Simmz64/EmbeddedProject/Images/powersupply.jpg

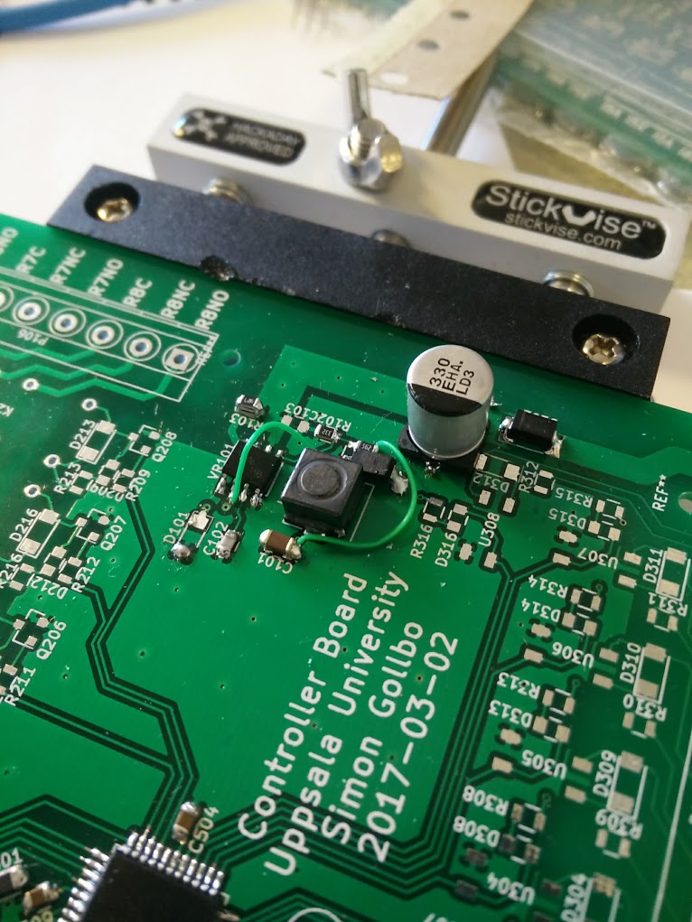
Images/powersupply.jpg
