Simmz64/EmbeddedProject/Images/Prototype.jpg

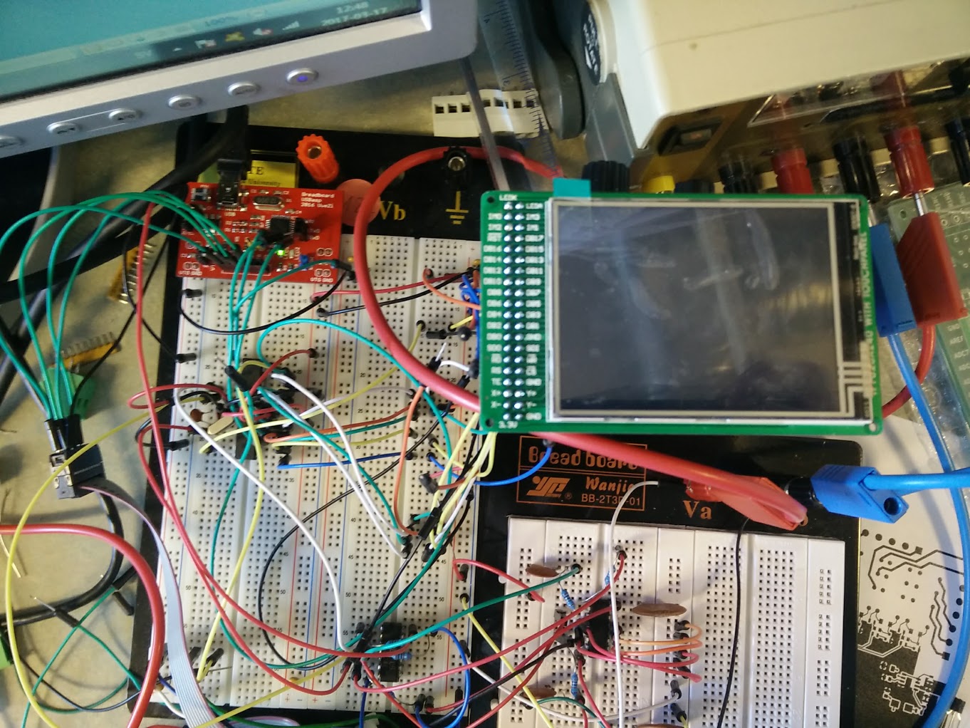
Images/Prototype.jpg
