Simmz64/EmbeddedProject/README.md

# EmbeddedProject
Project course in embedded systems
