Simmz64/EmbeddedProject/Cut from report.txt

1.1.	PID-controller
A Proportional Integrating Differentiating-controller, or PID-controller, is a feedback controller which takes as input a reference level. The difference between the reference signal and the system output is called the control error. A correctly designed controller attempts to generate control signals such that the control error goes to zero. Worded differently, the controller compares the reference level to the current output level of the system and generates a control signal, which is sent to the system with the aim to control the system to the reference level.
As the name suggests, a PID-controller consists of three parts, a proportional feedback, an integrating feedback and a differentiating feedback. These three parts each have a feedback gain assigned to them, essentially controlling how much each of the three parts affects the control signal. The process of determining sufficiently good values for the feedback gains is called tuning.
The proportional feedback is, as the name suggests, proportional to the control error. The proportional feedback gain is simply a constant with which the control error is multiplied. It is very direct in its acting, essentially constantly telling the system to move in the direction of the reference signal.
The integrating feedback keeps track of the control error over time. When properly designed, it ensures that the system, if stable, is controlled to control error zero in the steady state. Compared to the proportional feedback, the integrating feedback is slower but is able to compensate for small errors, which the proportional feedback may not be able to, given enough time.
The differentiating feedback is related to fast changes in the control error. If the system suddenly jerks, the differentiating feedback is able to provide the control signal with an extra boost to compensate for the quick change in system output.
