Simmz64/EmbeddedProject/SimonGollbo_EmbeddedProject_Final.pptx

## Electron gun vacuum system control

Project in Embedded Systems

## Outline

- Purpose and project specifications
- Work
- Results and summary
- Demonstration

## Purpose

- Control system for vacuum system

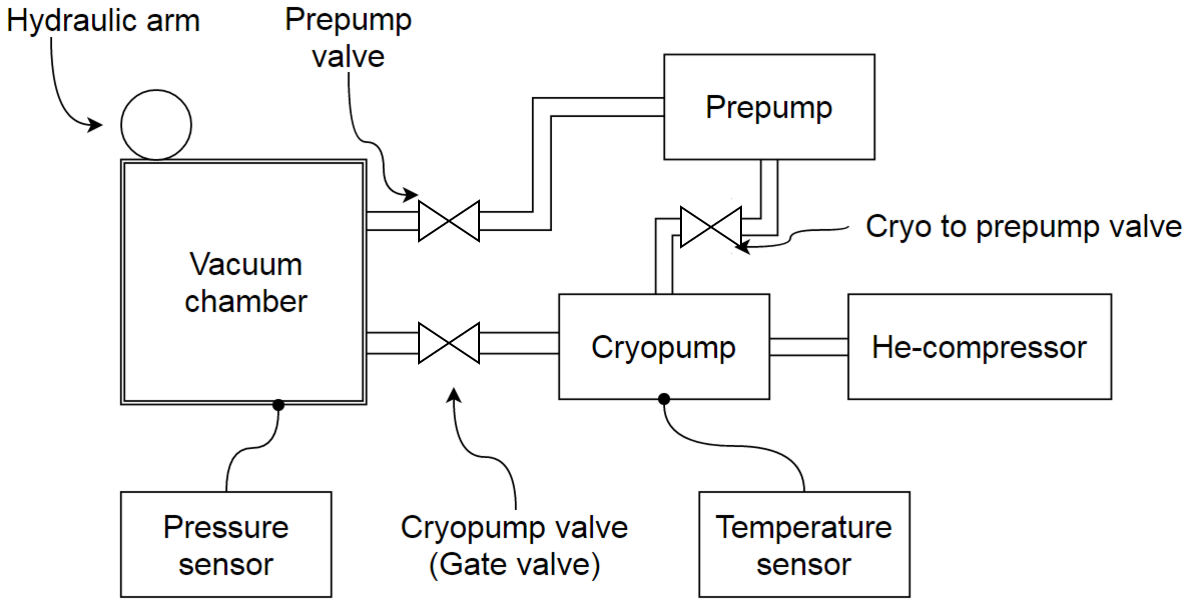
[picture p19: figure]

## Specifications

- Milestones
  - Prototype on breadboard with working touch screen and digital I/O
  - Prototype on breadboard with working universal PID-controller
  - Finished PCB with working universal PID-controller

## Development tools

- AtmelStudio 7.0
- Sublime Text
- Git
- AVRDUDESS
- KiCad

## Work

- Software
  - Microcontroller
  - Touch screen display
  - Touch screen touch interface
    - Polling
  - GUI
  - Controls
    - Binary search
  - PID-controller

## Work

- Prototype


## Work

- PCB design
  - Datasheets
  - Footprints
- KiCad

## Work

- PCB

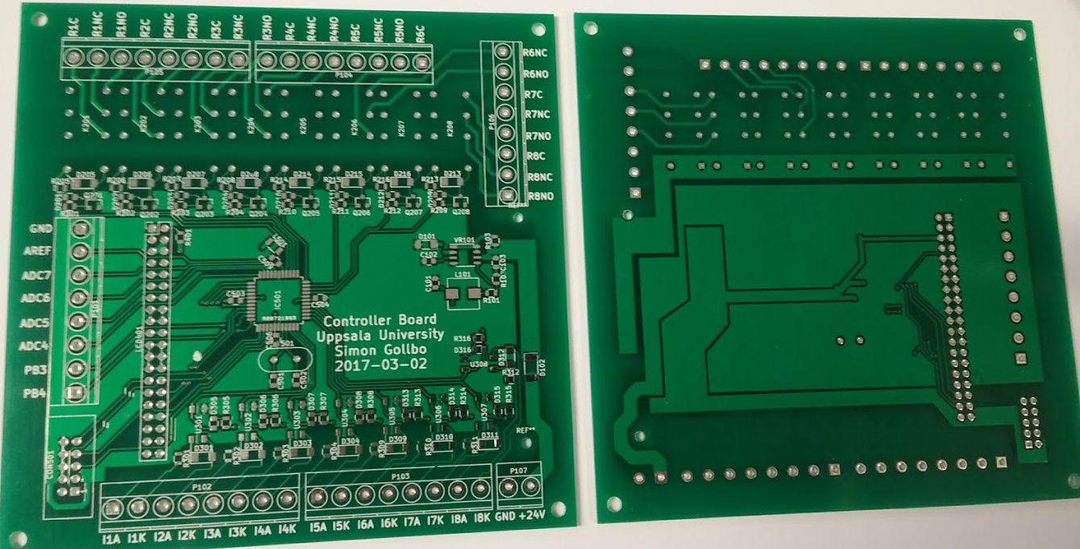
[picture p20: figure]
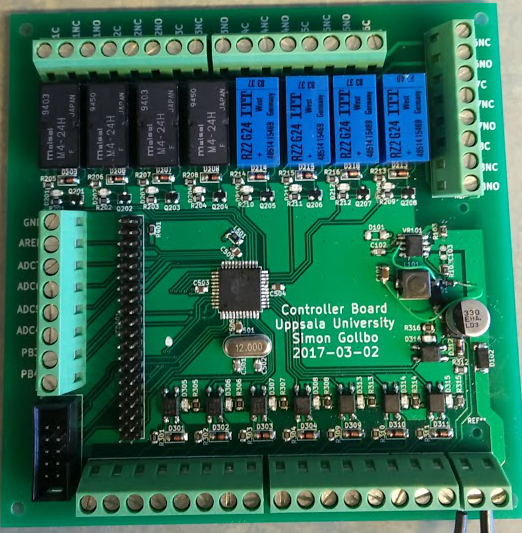
[picture p21: figure]
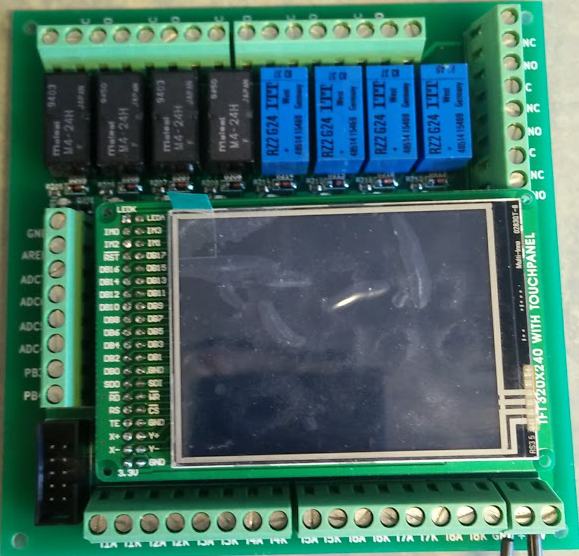
[picture p22: figure]
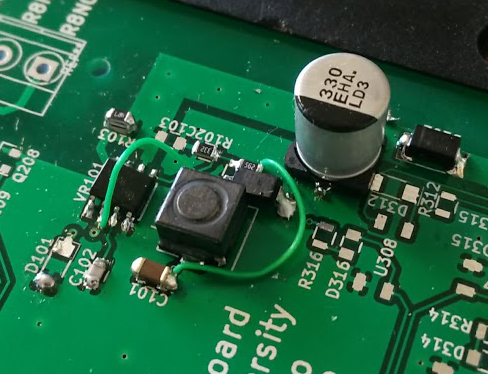
[picture p23: figure]

## Results

- Working PCB
  - GUI for vacuum system
  - GUI for PID-controller

## Summary

- Prototype and test
- PCB design
- PCB test

## Demonstration

## Slide 13
