Simmz64/EmbeddedProject/SimonGollbo_EmbeddedProject_Phase2.pptx

## Phase 2

Work done and progress made

## Outline

- Work done
- Progress made
- Next phase

## Work done

- Additional coding
  - Numerical input interface
  - Started PID-interface
  - Fixed-point decimal handling
  - ADC tested (using PWM + LP filter)

## Work done

- PCB design
  - Schematics drawn (not yet complete)
  - PCB placement started (also not yet complete)
- Relays
  - Testing of mechanical relays
  - To be used as input/output

## Progress made

- PCB progress
- Code progress
- Relays (input/output)
- Time schedule

## Next phase

- Focus on
  - Software logic (what action are allowed when)
  - Finishing PCB
  - Finishing PID
