Simmz64/EmbeddedProject/SimonGollbo_EmbeddedProject_Phase1.pptx

## Phase 1

Work done and progress made

## Outline

- Work done
- Progress made
- Next phase

## Work done

- Pre-lab access
  - Git repository
  - Seeking information
    - Screen
    - Code examples
  - Clean room

## Work done

- Post-lab access
  - Getting the screen to work
    - Communication protocol
    - Decoding datasheet
  - Getting the touch interface to work
    - Measurement method
  - Starting GUI design
    - Detail
    - Drawing speed
  - Specifications for PCB

## Progress made

- Screen
  - Works
  - Library
- Touch interface
  - Measurements
  - Library
- PCB
- Time schedule

## Next phase

- Focus on
  - PCB design
  - Software logic
  - Microcontroller to industrial electronics
  - PID regulator
  - Some minor GUI work
