Simmz64/EmbeddedProject/Images/PCB1.jpg

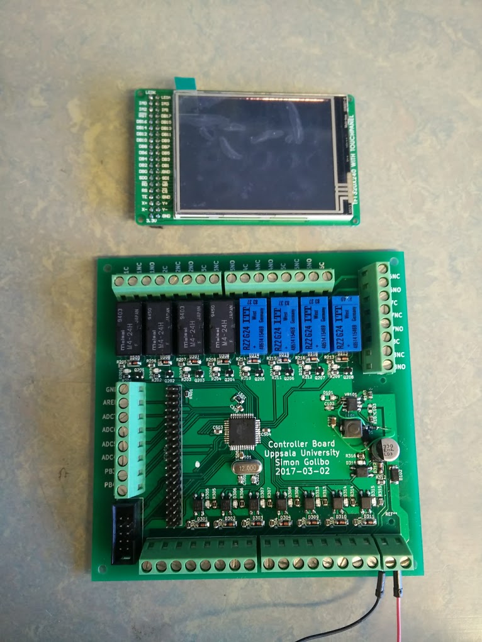
Images/PCB1.jpg
