Simmz64/EmbeddedProject/Images/PCB_clean.jpg

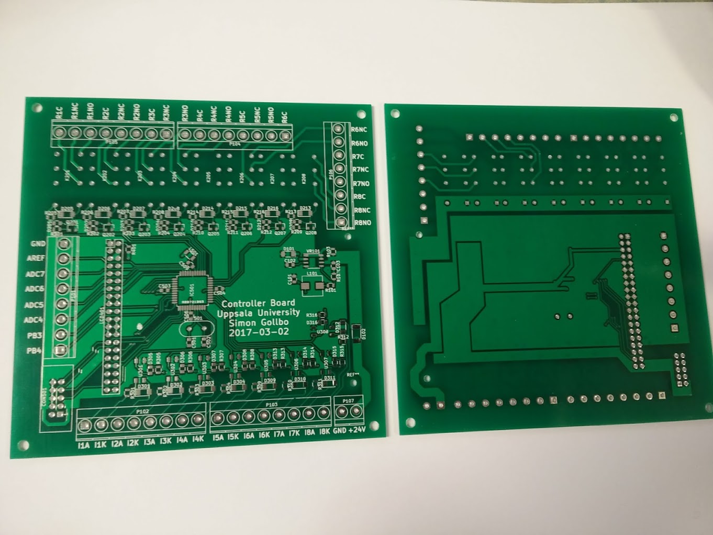
Images/PCB_clean.jpg
