Simmz64/EmbeddedProject/Images/PCB_complete.jpg

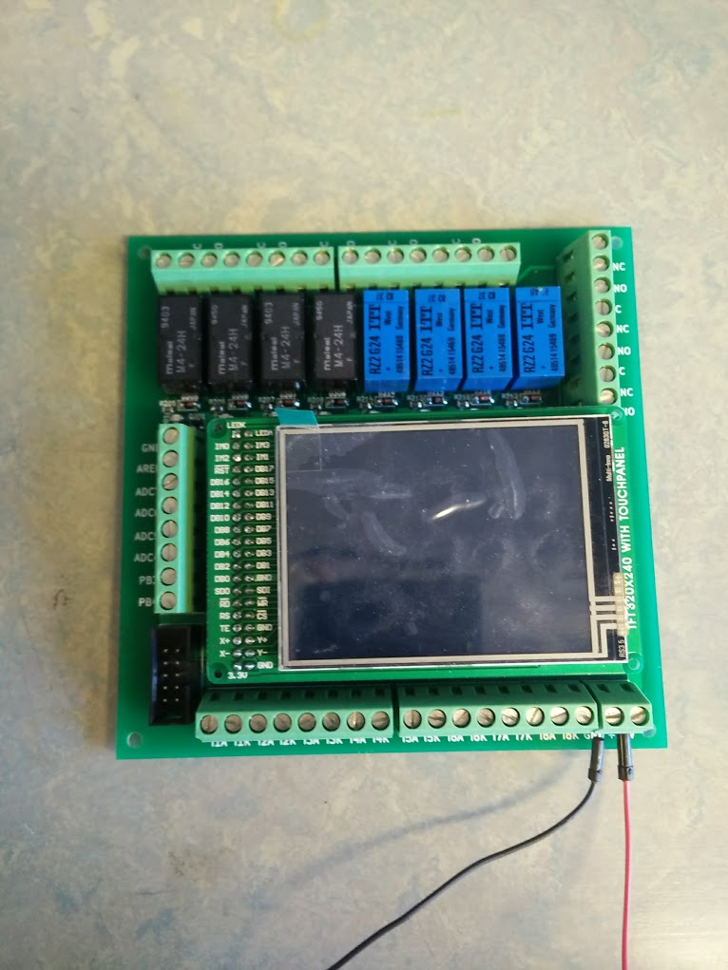
Images/PCB_complete.jpg
