Simmz64/EmbeddedProject/Komponenter/BillOfMaterials_ControlCircuit.pdf

comp_id | value
5 | 32pF
7 | 4uF
8 | 100uF
50 | LED
52 | LED
54 | LED
56 | LED
58 | LED
60 | LED
62 | LED
64 | LED
90 | LED
92 | LED
94 | LED
96 | LED
98 | LED
100 | LED
102 | LED
104 | LED
111 | 27pF
112 | 27pF
114 | 100uF
115 | 100uF
116 | 100uF
117 | 100uF
113 | 10uH
109 | AVR-ISP-10
10 | CONN_01X02
11 | CONN_01X08
12 | CONN_01X08
13 | CONN_01X08
14 | CONN_01X08
15 | CONN_01X08
16 | CONN_01X08
110 | Crystal
17 | D (MELF)
9 | D_Schottky
21 | D
25 | D
29 | D
33 | D
37 | D
41 | D
45 | D
49 | D
67 | D
70 | D
73 | D
76 | D
79 | D
82 | D
85 | D
88 | D
108 | ATMEGA644-A
1 | MC34063A
6 | 260mH
18 | Meisei-m4-24h
22 | Meisei-m4-24h

26 | Meisei-m4-24h
30 | Meisei-m4-24h
34 | Meisei-m4-24h
38 | Meisei-m4-24h
42 | Meisei-m4-24h
46 | Meisei-m4-24h
19 | Q_NPN_BCE
23 | Q_NPN_BCE
27 | Q_NPN_BCE
31 | Q_NPN_BCE
35 | Q_NPN_BCE
39 | Q_NPN_BCE
43 | Q_NPN_BCE
47 | Q_NPN_BCE
66 | HCPL-181-06BE
69 | HCPL-181-06BE
72 | HCPL-181-06BE
75 | HCPL-181-06BE
78 | HCPL-181-06BE
81 | HCPL-181-06BE
84 | HCPL-181-06BE
87 | HCPL-181-06BE
106 | tft-proto-mi0283qt-9a
2 | 18kR
3 | 11kR
20 | 10kR
24 | 10kR
28 | 10kR
32 | 10kR
36 | 10kR
40 | 10kR
44 | 10kR
48 | 10kR
51 | 10kR
53 | 10kR
55 | 10kR
57 | 10kR
59 | 10kR
61 | 10kR
63 | 10kR
65 | 10kR
68 | 2kR
71 | 2kR
74 | 2kR
77 | 2kR
80 | 2kR
83 | 2kR
86 | 2kR
89 | 2kR
91 | 1kR
93 | 1kR
95 | 1kR
97 | 1kR
99 | 1kR
101 | 1kR
103 | 1kR
105 | 1kR
107 | 100R
4 | 1.5R

footprint | tstamp | ref | Antal
Capacitors_SMD:C_0805 | 58ADC3B5 | C102 | 1
Capacitors_SMD:C_0805 | 58ADC46F | C101 | 1
Capacitors_SMD:C_0805 | 58ADC4C2 | C103 | 1
Capacitors_SMD:C_0805 | 58B75E5F | D209
Capacitors_SMD:C_0805 | 58B77770 | D212
Capacitors_SMD:C_0805 | 58B79DE6 | D204
Capacitors_SMD:C_0805 | 58B79F0F | D203
Capacitors_SMD:C_0805 | 58B7A016 | D211
Capacitors_SMD:C_0805 | 58B7A165 | D210
Capacitors_SMD:C_0805 | 58B7A28C | D202
Capacitors_SMD:C_0805 | 58B7A381 | D201
Capacitors_SMD:C_0805 | 58B85306 | D305
Capacitors_SMD:C_0805 | 58B853B4 | D307
Capacitors_SMD:C_0805 | 58B85438 | D306
Capacitors_SMD:C_0805 | 58B854CE | D308
Capacitors_SMD:C_0805 | 58B85556 | D313
Capacitors_SMD:C_0805 | 58B85620 | D314
Capacitors_SMD:C_0805 | 58B856F8 | D315 | Antal
Capacitors_SMD:C_0805 | 58B857BA | D316 | 16
Capacitors_SMD:C_0805 | 58AFE5FE | C501 | 1
Capacitors_SMD:C_0805 | 58AFE643 | C502 | 1
Capacitors_SMD:C_0805 | 58B7F754 | C509
Capacitors_SMD:C_0805 | 58B7F7C6 | C503
Capacitors_SMD:C_0805 | 58B819B7 | C504 | Antal
Capacitors_SMD:C_0805 | 58B819EA | C506 | 4
Capacitors_SMD:C_1206 | 58B7F6E5 | L501 | 1
Connectors:IDC_Header_Straight_10pins | 58AFDD08 | CON501 | 1
Connectors_Terminal_Blocks:TerminalBlock_Pheonix_MKDS1.5-2pol | 58B072B8 | P107 | 1
Connectors_Terminal_Blocks:TerminalBlock_Pheonix_MKDS1.5-8pol | 58B3B87B | P102
Connectors_Terminal_Blocks:TerminalBlock_Pheonix_MKDS1.5-8pol | 58B3CE21 | P105
Connectors_Terminal_Blocks:TerminalBlock_Pheonix_MKDS1.5-8pol | 58B3D077 | P104
Connectors_Terminal_Blocks:TerminalBlock_Pheonix_MKDS1.5-8pol | 58B3D2CE | P106
Connectors_Terminal_Blocks:TerminalBlock_Pheonix_MKDS1.5-8pol | 58B5A21E | P103 | Antal
Connectors_Terminal_Blocks:TerminalBlock_Pheonix_MKDS1.5-8pol | 58B62A9C | P101 | 6
Crystals:Crystal_HC49-U_Vertical | 58AFE5B1 | Y501 | 1
Diodes_SMD:D_MELF_Standard | 58BAFEB2 | D102 | 1
Diodes_SMD:D_MiniMELF_Standard | 58ADC506 | D101 | 1
Diodes_SMD:D_MiniMELF_Standard | 58AE6BBC | D208
Diodes_SMD:D_MiniMELF_Standard | 58AE898F | D214
Diodes_SMD:D_MiniMELF_Standard | 58AE8A67 | D215
Diodes_SMD:D_MiniMELF_Standard | 58AE8E43 | D205
Diodes_SMD:D_MiniMELF_Standard | 58AE8E83 | D206
Diodes_SMD:D_MiniMELF_Standard | 58AE8EC3 | D207
Diodes_SMD:D_MiniMELF_Standard | 58B0DA2A | D216
Diodes_SMD:D_MiniMELF_Standard | 58B0DA5D | D213
Diodes_SMD:D_MiniMELF_Standard | 58B4FD7A | D309
Diodes_SMD:D_MiniMELF_Standard | 58B50714 | D310
Diodes_SMD:D_MiniMELF_Standard | 58B51C94 | D311
Diodes_SMD:D_MiniMELF_Standard | 58B51CBB | D312
Diodes_SMD:D_MiniMELF_Standard | 58B51EF5 | D301
Diodes_SMD:D_MiniMELF_Standard | 58B51F1C | D302
Diodes_SMD:D_MiniMELF_Standard | 58B51F43 | D303 | Antal
Diodes_SMD:D_MiniMELF_Standard | 58B51F6A | D304 | 16
Housings_QFP:LQFP-44_10x10mm_Pitch0.8mm | 58AFCD20 | IC501 | 1
Housings_SOIC:SOIC-8_3.9x4.9mm_Pitch1.27mm | 58ADBEF0 | VR101 | 1
Inductors:Inductor_Wurth_HCI-7050 | 58ADC41A | L101 | 1
Meisei:Meisei-m4-24h | 58ADF9BD | K204
Meisei:Meisei-m4-24h | 58AE8967 | K205

Meisei:Meisei-m4-24h | 58AE8A3F | K206
Meisei:Meisei-m4-24h | 58AE8E17 | K201
Meisei:Meisei-m4-24h | 58AE8E57 | K202
Meisei:Meisei-m4-24h | 58AE8E97 | K203
Meisei:Meisei-m4-24h | 58B0DA07 | K207 | Antal
Meisei:Meisei-m4-24h | 58B0DA3A | K208 | 8
MMBT3904:MMBT3904 | 58ADF9C4 | Q204
MMBT3904:MMBT3904 | 58AE896D | Q205
MMBT3904:MMBT3904 | 58AE8A45 | Q206
MMBT3904:MMBT3904 | 58AE8E1D | Q201
MMBT3904:MMBT3904 | 58AE8E5D | Q202
MMBT3904:MMBT3904 | 58AE8E9D | Q203
MMBT3904:MMBT3904 | 58B0DA0D | Q207 | Antal
MMBT3904:MMBT3904 | 58B0DA40 | Q208 | 8
OptoSOP:OptoSOP | 58B4F7B2 | U305
OptoSOP:OptoSOP | 58B5070E | U306
OptoSOP:OptoSOP | 58B51C8E | U307
OptoSOP:OptoSOP | 58B51CB5 | U308
OptoSOP:OptoSOP | 58B51EEF | U301
OptoSOP:OptoSOP | 58B51F16 | U302
OptoSOP:OptoSOP | 58B51F3D | U303 | Antal
OptoSOP:OptoSOP | 58B51F64 | U304 | 8
Pin_Headers:Pin_Header_Straight_2x20_Pitch2.54mm | 58AFAB48 | LCD401 | 1
Resistors_SMD:R_0805 | 58ADBF75 | R101 | 1
Resistors_SMD:R_0805 | 58ADC02F | R102 | 1
Resistors_SMD:R_0805 | 58ADF9CB | R204
Resistors_SMD:R_0805 | 58AE8973 | R210
Resistors_SMD:R_0805 | 58AE8A4B | R211
Resistors_SMD:R_0805 | 58AE8E23 | R201
Resistors_SMD:R_0805 | 58AE8E63 | R202
Resistors_SMD:R_0805 | 58AE8EA3 | R203
Resistors_SMD:R_0805 | 58B0DA13 | R212
Resistors_SMD:R_0805 | 58B0DA46 | R209
Resistors_SMD:R_0805 | 58B75EDE | R213
Resistors_SMD:R_0805 | 58B77776 | R216
Resistors_SMD:R_0805 | 58B79DEC | R208
Resistors_SMD:R_0805 | 58B79F15 | R207
Resistors_SMD:R_0805 | 58B7A01C | R215
Resistors_SMD:R_0805 | 58B7A16B | R214
Resistors_SMD:R_0805 | 58B7A292 | R206 | Antal
Resistors_SMD:R_0805 | 58B7A387 | R205 | 16
Resistors_SMD:R_0805 | 58B4FDCB | R309
Resistors_SMD:R_0805 | 58B5071A | R310
Resistors_SMD:R_0805 | 58B51C9A | R311
Resistors_SMD:R_0805 | 58B51CC1 | R312
Resistors_SMD:R_0805 | 58B51EFB | R301
Resistors_SMD:R_0805 | 58B51F22 | R302
Resistors_SMD:R_0805 | 58B51F49 | R303 | Antal
Resistors_SMD:R_0805 | 58B51F70 | R304 | 8
Resistors_SMD:R_0805 | 58B8530C | R305
Resistors_SMD:R_0805 | 58B853BA | R307
Resistors_SMD:R_0805 | 58B8543E | R306
Resistors_SMD:R_0805 | 58B854D4 | R308
Resistors_SMD:R_0805 | 58B8555C | R313
Resistors_SMD:R_0805 | 58B85626 | R314
Resistors_SMD:R_0805 | 58B856FE | R315 | Antal
Resistors_SMD:R_0805 | 58B857C0 | R316 | 8
Resistors_SMD:R_0805 | 58AFAB4F | R401 | 1
Resistors_SMD:R_0805 | 58ADC09B | R103 | 1

Komponent | Antal Kommentar
Capacitors_SMD:C_0805 | 25
Capacitors_SMD:C_1206 | 1
Connectors:IDC_Header_Straight_10pins | 1
Connectors_Terminal_Blocks:TerminalBlock_Pheonix_MKDS1.5-2pol | 1
Connectors_Terminal_Blocks:TerminalBlock_Pheonix_MKDS1.5-8pol | 6
Crystals:Crystal_HC49-U_Vertical | 1
Diodes_SMD:D_MELF_Standard | 1
Diodes_SMD:D_MiniMELF_Standard | 17
Housings_QFP:LQFP-44_10x10mm_Pitch0.8mm | 1
Housings_SOIC:SOIC-8_3.9x4.9mm_Pitch1.27mm | 1
Inductors:Inductor_Wurth_HCI-7050 | 1
Meisei:Meisei-m4-24h | 8
MMBT3904:MMBT3904 | 8
OptoSOP:OptoSOP | 8 HCPL-181-06BE
Pin_Headers:Pin_Header_Straight_2x20_Pitch2.54mm | 1
Resistors_SMD:R_0805 | 36

Kommentar
Finns på Farnell och RS-components (dock i utförandet HCPL-181-00BE på RS-components, men de verkar likvärdiga)

Har utgått ur sortimentet på Elfa
