Simmz64/EmbeddedProject/Komponenter/BillOfMaterials_ControlCircuit.xlsx

Sheet: Components
comp_id | value | footprint | tstamp | ref | Antal | Komponent | Antal | Kommentar
5 | 32pF | Capacitors_SMD:C_0805 | 58ADC3B5 | C102 | 1 | Capacitors_SMD:C_0805 | 25
7 | 4uF | Capacitors_SMD:C_0805 | 58ADC46F | C101 | 1 | Capacitors_SMD:C_1206 | 1
8 | 100uF | Capacitors_SMD:C_0805 | 58ADC4C2 | C103 | 1 | Connectors:IDC_Header_Straight_10pins | 1
50 | LED | Capacitors_SMD:C_0805 | 58B75E5F | D209 |  | Connectors_Terminal_Blocks:TerminalBlock_Pheonix_MKDS1.5-2pol | 1
52 | LED | Capacitors_SMD:C_0805 | 58B77770 | D212 |  | Connectors_Terminal_Blocks:TerminalBlock_Pheonix_MKDS1.5-8pol | 6
54 | LED | Capacitors_SMD:C_0805 | 58B79DE6 | D204 |  | Crystals:Crystal_HC49-U_Vertical | 1
56 | LED | Capacitors_SMD:C_0805 | 58B79F0F | D203 |  | Diodes_SMD:D_MELF_Standard | 1
58 | LED | Capacitors_SMD:C_0805 | 58B7A016 | D211 |  | Diodes_SMD:D_MiniMELF_Standard | 17
60 | LED | Capacitors_SMD:C_0805 | 58B7A165 | D210 |  | Housings_QFP:LQFP-44_10x10mm_Pitch0.8mm | 1
62 | LED | Capacitors_SMD:C_0805 | 58B7A28C | D202 |  | Housings_SOIC:SOIC-8_3.9x4.9mm_Pitch1.27mm | 1
64 | LED | Capacitors_SMD:C_0805 | 58B7A381 | D201 |  | Inductors:Inductor_Wurth_HCI-7050 | 1
90 | LED | Capacitors_SMD:C_0805 | 58B85306 | D305 |  | Meisei:Meisei-m4-24h | 8
92 | LED | Capacitors_SMD:C_0805 | 58B853B4 | D307 |  | MMBT3904:MMBT3904 | 8
94 | LED | Capacitors_SMD:C_0805 | 58B85438 | D306 |  | OptoSOP:OptoSOP | 8 | HCPL-181-06BE
96 | LED | Capacitors_SMD:C_0805 | 58B854CE | D308 |  | Pin_Headers:Pin_Header_Straight_2x20_Pitch2.54mm | 1
98 | LED | Capacitors_SMD:C_0805 | 58B85556 | D313 |  | Resistors_SMD:R_0805 | 36
100 | LED | Capacitors_SMD:C_0805 | 58B85620 | D314
102 | LED | Capacitors_SMD:C_0805 | 58B856F8 | D315 | Antal
104 | LED | Capacitors_SMD:C_0805 | 58B857BA | D316 | 16
111 | 27pF | Capacitors_SMD:C_0805 | 58AFE5FE | C501 | 1
112 | 27pF | Capacitors_SMD:C_0805 | 58AFE643 | C502 | 1
114 | 100uF | Capacitors_SMD:C_0805 | 58B7F754 | C509
115 | 100uF | Capacitors_SMD:C_0805 | 58B7F7C6 | C503
116 | 100uF | Capacitors_SMD:C_0805 | 58B819B7 | C504 | Antal
117 | 100uF | Capacitors_SMD:C_0805 | 58B819EA | C506 | 4
113 | 10uH | Capacitors_SMD:C_1206 | 58B7F6E5 | L501 | 1
109 | AVR-ISP-10 | Connectors:IDC_Header_Straight_10pins | 58AFDD08 | CON501 | 1
10 | CONN_01X02 | Connectors_Terminal_Blocks:TerminalBlock_Pheonix_MKDS1.5-2pol | 58B072B8 | P107 | 1
11 | CONN_01X08 | Connectors_Terminal_Blocks:TerminalBlock_Pheonix_MKDS1.5-8pol | 58B3B87B | P102
12 | CONN_01X08 | Connectors_Terminal_Blocks:TerminalBlock_Pheonix_MKDS1.5-8pol | 58B3CE21 | P105
13 | CONN_01X08 | Connectors_Terminal_Blocks:TerminalBlock_Pheonix_MKDS1.5-8pol | 58B3D077 | P104
14 | CONN_01X08 | Connectors_Terminal_Blocks:TerminalBlock_Pheonix_MKDS1.5-8pol | 58B3D2CE | P106
15 | CONN_01X08 | Connectors_Terminal_Blocks:TerminalBlock_Pheonix_MKDS1.5-8pol | 58B5A21E | P103 | Antal
16 | CONN_01X08 | Connectors_Terminal_Blocks:TerminalBlock_Pheonix_MKDS1.5-8pol | 58B62A9C | P101 | 6
110 | Crystal | Crystals:Crystal_HC49-U_Vertical | 58AFE5B1 | Y501 | 1
17 | D (MELF) | Diodes_SMD:D_MELF_Standard | 58BAFEB2 | D102 | 1
9 | D_Schottky | Diodes_SMD:D_MiniMELF_Standard | 58ADC506 | D101 | 1
21 | D | Diodes_SMD:D_MiniMELF_Standard | 58AE6BBC | D208
25 | D | Diodes_SMD:D_MiniMELF_Standard | 58AE898F | D214
29 | D | Diodes_SMD:D_MiniMELF_Standard | 58AE8A67 | D215
33 | D | Diodes_SMD:D_MiniMELF_Standard | 58AE8E43 | D205
37 | D | Diodes_SMD:D_MiniMELF_Standard | 58AE8E83 | D206
41 | D | Diodes_SMD:D_MiniMELF_Standard | 58AE8EC3 | D207
45 | D | Diodes_SMD:D_MiniMELF_Standard | 58B0DA2A | D216
49 | D | Diodes_SMD:D_MiniMELF_Standard | 58B0DA5D | D213
67 | D | Diodes_SMD:D_MiniMELF_Standard | 58B4FD7A | D309
70 | D | Diodes_SMD:D_MiniMELF_Standard | 58B50714 | D310
73 | D | Diodes_SMD:D_MiniMELF_Standard | 58B51C94 | D311
76 | D | Diodes_SMD:D_MiniMELF_Standard | 58B51CBB | D312
79 | D | Diodes_SMD:D_MiniMELF_Standard | 58B51EF5 | D301
82 | D | Diodes_SMD:D_MiniMELF_Standard | 58B51F1C | D302
85 | D | Diodes_SMD:D_MiniMELF_Standard | 58B51F43 | D303 | Antal
88 | D | Diodes_SMD:D_MiniMELF_Standard | 58B51F6A | D304 | 16
108 | ATMEGA644-A | Housings_QFP:LQFP-44_10x10mm_Pitch0.8mm | 58AFCD20 | IC501 | 1
1 | MC34063A | Housings_SOIC:SOIC-8_3.9x4.9mm_Pitch1.27mm | 58ADBEF0 | VR101 | 1
6 | 260mH | Inductors:Inductor_Wurth_HCI-7050 | 58ADC41A | L101 | 1
18 | Meisei-m4-24h | Meisei:Meisei-m4-24h | 58ADF9BD | K204
22 | Meisei-m4-24h | Meisei:Meisei-m4-24h | 58AE8967 | K205
26 | Meisei-m4-24h | Meisei:Meisei-m4-24h | 58AE8A3F | K206
30 | Meisei-m4-24h | Meisei:Meisei-m4-24h | 58AE8E17 | K201
34 | Meisei-m4-24h | Meisei:Meisei-m4-24h | 58AE8E57 | K202
38 | Meisei-m4-24h | Meisei:Meisei-m4-24h | 58AE8E97 | K203
42 | Meisei-m4-24h | Meisei:Meisei-m4-24h | 58B0DA07 | K207 | Antal
46 | Meisei-m4-24h | Meisei:Meisei-m4-24h | 58B0DA3A | K208 | 8
19 | Q_NPN_BCE | MMBT3904:MMBT3904 | 58ADF9C4 | Q204
23 | Q_NPN_BCE | MMBT3904:MMBT3904 | 58AE896D | Q205
27 | Q_NPN_BCE | MMBT3904:MMBT3904 | 58AE8A45 | Q206
31 | Q_NPN_BCE | MMBT3904:MMBT3904 | 58AE8E1D | Q201
35 | Q_NPN_BCE | MMBT3904:MMBT3904 | 58AE8E5D | Q202
39 | Q_NPN_BCE | MMBT3904:MMBT3904 | 58AE8E9D | Q203
43 | Q_NPN_BCE | MMBT3904:MMBT3904 | 58B0DA0D | Q207 | Antal
47 | Q_NPN_BCE | MMBT3904:MMBT3904 | 58B0DA40 | Q208 | 8
66 | HCPL-181-06BE | OptoSOP:OptoSOP | 58B4F7B2 | U305 |  | Kommentar
69 | HCPL-181-06BE | OptoSOP:OptoSOP | 58B5070E | U306 |  | Finns på Farnell och RS-components (dock i utförandet
72 | HCPL-181-06BE | OptoSOP:OptoSOP | 58B51C8E | U307 |  | HCPL-181-00BE på RS-components, men de verkar likvärdiga)
75 | HCPL-181-06BE | OptoSOP:OptoSOP | 58B51CB5 | U308
78 | HCPL-181-06BE | OptoSOP:OptoSOP | 58B51EEF | U301 |  | Har utgått ur sortimentet på Elfa
81 | HCPL-181-06BE | OptoSOP:OptoSOP | 58B51F16 | U302
84 | HCPL-181-06BE | OptoSOP:OptoSOP | 58B51F3D | U303 | Antal
87 | HCPL-181-06BE | OptoSOP:OptoSOP | 58B51F64 | U304 | 8
106 | tft-proto-mi0283qt-9a | Pin_Headers:Pin_Header_Straight_2x20_Pitch2.54mm | 58AFAB48 | LCD401 | 1
2 | 18kR | Resistors_SMD:R_0805 | 58ADBF75 | R101 | 1
3 | 11kR | Resistors_SMD:R_0805 | 58ADC02F | R102 | 1
20 | 10kR | Resistors_SMD:R_0805 | 58ADF9CB | R204
24 | 10kR | Resistors_SMD:R_0805 | 58AE8973 | R210
28 | 10kR | Resistors_SMD:R_0805 | 58AE8A4B | R211
32 | 10kR | Resistors_SMD:R_0805 | 58AE8E23 | R201
36 | 10kR | Resistors_SMD:R_0805 | 58AE8E63 | R202
40 | 10kR | Resistors_SMD:R_0805 | 58AE8EA3 | R203
44 | 10kR | Resistors_SMD:R_0805 | 58B0DA13 | R212
48 | 10kR | Resistors_SMD:R_0805 | 58B0DA46 | R209
51 | 10kR | Resistors_SMD:R_0805 | 58B75EDE | R213
53 | 10kR | Resistors_SMD:R_0805 | 58B77776 | R216
55 | 10kR | Resistors_SMD:R_0805 | 58B79DEC | R208
57 | 10kR | Resistors_SMD:R_0805 | 58B79F15 | R207
59 | 10kR | Resistors_SMD:R_0805 | 58B7A01C | R215
61 | 10kR | Resistors_SMD:R_0805 | 58B7A16B | R214
63 | 10kR | Resistors_SMD:R_0805 | 58B7A292 | R206 | Antal
65 | 10kR | Resistors_SMD:R_0805 | 58B7A387 | R205 | 16
68 | 2kR | Resistors_SMD:R_0805 | 58B4FDCB | R309
71 | 2kR | Resistors_SMD:R_0805 | 58B5071A | R310
74 | 2kR | Resistors_SMD:R_0805 | 58B51C9A | R311
77 | 2kR | Resistors_SMD:R_0805 | 58B51CC1 | R312
80 | 2kR | Resistors_SMD:R_0805 | 58B51EFB | R301
83 | 2kR | Resistors_SMD:R_0805 | 58B51F22 | R302
86 | 2kR | Resistors_SMD:R_0805 | 58B51F49 | R303 | Antal
89 | 2kR | Resistors_SMD:R_0805 | 58B51F70 | R304 | 8
91 | 1kR | Resistors_SMD:R_0805 | 58B8530C | R305
93 | 1kR | Resistors_SMD:R_0805 | 58B853BA | R307
95 | 1kR | Resistors_SMD:R_0805 | 58B8543E | R306
97 | 1kR | Resistors_SMD:R_0805 | 58B854D4 | R308
99 | 1kR | Resistors_SMD:R_0805 | 58B8555C | R313
101 | 1kR | Resistors_SMD:R_0805 | 58B85626 | R314
103 | 1kR | Resistors_SMD:R_0805 | 58B856FE | R315 | Antal
105 | 1kR | Resistors_SMD:R_0805 | 58B857C0 | R316 | 8
107 | 100R | Resistors_SMD:R_0805 | 58AFAB4F | R401 | 1
4 | 1.5R | Resistors_SMD:R_0805 | 58ADC09B | R103 | 1

Sheet: Components, condensed
ref | value | L101 | 260mH | U301 | Opto
C101 | 4uF | L501 | 10uH | U302 | Opto
C102 | 32pF | LCD401 | tft-proto | U303 | Opto
C103 | 100uF | P101 | CONN_01X08 | U304 | Opto
C501 | 27pF | P102 | CONN_01X08 | U305 | Opto
C502 | 27pF | P103 | CONN_01X08 | U306 | Opto
C503 | 100uF | P104 | CONN_01X08 | U307 | Opto
C504 | 100uF | P105 | CONN_01X08 | U308 | Opto
C506 | 100uF | P106 | CONN_01X08 | VR101 | MC34063A
C509 | 100uF | P107 | CONN_01X02 | Y501 | Crystal
CON501 | AVR-ISP-10 | Q201 | Q_NPN_BCE
D101 | D_Schottky | Q202 | Q_NPN_BCE
D102 | D (MELF) | Q203 | Q_NPN_BCE
D201 | LED | Q204 | Q_NPN_BCE
D202 | LED | Q205 | Q_NPN_BCE
D203 | LED | Q206 | Q_NPN_BCE
D204 | LED | Q207 | Q_NPN_BCE
D205 | D | Q208 | Q_NPN_BCE
D206 | D | R101 | 18kR
D207 | D | R102 | 11kR
D208 | D | R103 | 1.5R
D209 | LED | R201 | 10kR
D210 | LED | R202 | 10kR
D211 | LED | R203 | 10kR
D212 | LED | R204 | 10kR
D213 | D | R205 | 10kR
D214 | D | R206 | 10kR
D215 | D | R207 | 10kR
D216 | D | R208 | 10kR
D301 | D | R209 | 10kR
D302 | D | R210 | 10kR
D303 | D | R211 | 10kR
D304 | D | R212 | 10kR
D305 | LED | R213 | 10kR
D306 | LED | R214 | 10kR
D307 | LED | R215 | 10kR
D308 | LED | R216 | 10kR
D309 | D | R301 | 2kR
D310 | D | R302 | 2kR
D311 | D | R303 | 2kR
D312 | D | R304 | 2kR
D313 | LED | R305 | 1kR
D314 | LED | R306 | 1kR
D315 | LED | R307 | 1kR
D316 | LED | R308 | 1kR
IC501 | ATMEGA644-A | R309 | 2kR
K201 | Meisei-m4-24h | R310 | 2kR
K202 | Meisei-m4-24h | R311 | 2kR
K203 | Meisei-m4-24h | R312 | 2kR
K204 | Meisei-m4-24h | R313 | 1kR
K205 | Meisei-m4-24h | R314 | 1kR
K206 | Meisei-m4-24h | R315 | 1kR
K207 | Meisei-m4-24h | R316 | 1kR
K208 | Meisei-m4-24h | R401 | 100R

Sheet: Export
export_id | source | date | tool | components | libparts | libraries | nets | version
1 | C:/Users/Simon/Documents/Universitet/Projekt-i-inbyggda-system/Circuit/ControlCircuit.sch | 2017-03-02 15:14:06 | Eeschema 4.0.5 |  |  |  |  | D
design_id | export_id | source | date | tool
1 | 1 | C:/Users/Simon/Documents/Universitet/Projekt-i-inbyggda-system/Circuit/ControlCircuit.sch | 2017-03-02 15:14:06 | Eeschema 4.0.5
sheet_id | export_id | design_id | title | company | rev | date | source | number | name | tstamps
1 | 1 | 1 |  |  |  |  | ControlCircuit.sch | 1 | / | /
2 | 1 | 1 |  |  |  |  | RelayOutputs.sch | 2 | /RelayOutputs/ | /58ADF524/
3 | 1 | 1 |  |  |  |  | RelayInputs.sch | 3 | /RelayInputs/ | /58AE526D/
4 | 1 | 1 |  |  |  |  | LCDTouchScreen.sch | 4 | /LCDTouchScreen/ | /58AFA84F/
5 | 1 | 1 |  |  |  |  | Microcontroller.sch | 5 | /Microcontroller/ | /58AFCC8D/
title_block_id | export_id | design_id | sheet_id | title | company | rev | date | source
1 | 1 | 1 | 1 |  |  |  |  | ControlCircuit.sch
2 | 1 | 1 | 2 |  |  |  |  | RelayOutputs.sch
3 | 1 | 1 | 3 |  |  |  |  | RelayInputs.sch
4 | 1 | 1 | 4 |  |  |  |  | LCDTouchScreen.sch
5 | 1 | 1 | 5 |  |  |  |  | Microcontroller.sch
comment_id | export_id | design_id | sheet_id | title_block_id | number | value
1 | 1 | 1 | 1 | 1 | 1
2 | 1 | 1 | 1 | 1 | 2
3 | 1 | 1 | 1 | 1 | 3
4 | 1 | 1 | 1 | 1 | 4
5 | 1 | 1 | 2 | 1 | 1
6 | 1 | 1 | 2 | 1 | 2
7 | 1 | 1 | 2 | 1 | 3
8 | 1 | 1 | 2 | 1 | 4
9 | 1 | 1 | 3 | 1 | 1
10 | 1 | 1 | 3 | 1 | 2
11 | 1 | 1 | 3 | 1 | 3
12 | 1 | 1 | 3 | 1 | 4
13 | 1 | 1 | 4 | 1 | 1
14 | 1 | 1 | 4 | 1 | 2
15 | 1 | 1 | 4 | 1 | 3
16 | 1 | 1 | 4 | 1 | 4
17 | 1 | 1 | 5 | 1 | 1
18 | 1 | 1 | 5 | 1 | 2
19 | 1 | 1 | 5 | 1 | 3
20 | 1 | 1 | 5 | 1 | 4
components_id
1

Sheet: Libsource
libsource_id | export_id | components_id | comp_id | lib | part
1 | 1 | 1 | 1 | mc34063a | MC34063A
2 | 1 | 1 | 2 | device | R
3 | 1 | 1 | 3 | device | R
4 | 1 | 1 | 4 | device | R
5 | 1 | 1 | 5 | device | C
6 | 1 | 1 | 6 | device | L
7 | 1 | 1 | 7 | device | CP1
8 | 1 | 1 | 8 | device | CP1
9 | 1 | 1 | 9 | device | D_Schottky
10 | 1 | 1 | 10 | conn | CONN_01X02
11 | 1 | 1 | 11 | conn | CONN_01X08
12 | 1 | 1 | 12 | conn | CONN_01X08
13 | 1 | 1 | 13 | conn | CONN_01X08
14 | 1 | 1 | 14 | conn | CONN_01X08
15 | 1 | 1 | 15 | conn | CONN_01X08
16 | 1 | 1 | 16 | conn | CONN_01X08
17 | 1 | 1 | 17 | device | D
18 | 1 | 1 | 18 | meisei-m4-24h | Meisei-m4-24h
19 | 1 | 1 | 19 | ControlCircuit-rescue | Q_NPN_BCE-RESCUE-ControlCircuit
20 | 1 | 1 | 20 | device | R
21 | 1 | 1 | 21 | device | D
22 | 1 | 1 | 22 | meisei-m4-24h | Meisei-m4-24h
23 | 1 | 1 | 23 | ControlCircuit-rescue | Q_NPN_BCE-RESCUE-ControlCircuit
24 | 1 | 1 | 24 | device | R
25 | 1 | 1 | 25 | device | D
26 | 1 | 1 | 26 | meisei-m4-24h | Meisei-m4-24h
27 | 1 | 1 | 27 | ControlCircuit-rescue | Q_NPN_BCE-RESCUE-ControlCircuit
28 | 1 | 1 | 28 | device | R
29 | 1 | 1 | 29 | device | D
30 | 1 | 1 | 30 | meisei-m4-24h | Meisei-m4-24h
31 | 1 | 1 | 31 | ControlCircuit-rescue | Q_NPN_BCE-RESCUE-ControlCircuit
32 | 1 | 1 | 32 | device | R
33 | 1 | 1 | 33 | device | D
34 | 1 | 1 | 34 | meisei-m4-24h | Meisei-m4-24h
35 | 1 | 1 | 35 | ControlCircuit-rescue | Q_NPN_BCE-RESCUE-ControlCircuit
36 | 1 | 1 | 36 | device | R
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
109 | 1 | 1 | 109 | atmel | AVR-ISP-10
110 | 1 | 1 | 110 | device | Crystal
111 | 1 | 1 | 111 | device | C
112 | 1 | 1 | 112 | device | C
113 | 1 | 1 | 113 | device | L
114 | 1 | 1 | 114 | device | C
115 | 1 | 1 | 115 | device | C
116 | 1 | 1 | 116 | device | C
117 | 1 | 1 | 117 | device | C

Sheet: Sheetpath
sheetpath_id | export_id | components_id | comp_id | names | tstamps
1 | 1 | 1 | 1 | / | /
2 | 1 | 1 | 2 | / | /
3 | 1 | 1 | 3 | / | /
4 | 1 | 1 | 4 | / | /
5 | 1 | 1 | 5 | / | /
6 | 1 | 1 | 6 | / | /
7 | 1 | 1 | 7 | / | /
8 | 1 | 1 | 8 | / | /
9 | 1 | 1 | 9 | / | /
10 | 1 | 1 | 10 | / | /
11 | 1 | 1 | 11 | / | /
12 | 1 | 1 | 12 | / | /
13 | 1 | 1 | 13 | / | /
14 | 1 | 1 | 14 | / | /
15 | 1 | 1 | 15 | / | /
16 | 1 | 1 | 16 | / | /
17 | 1 | 1 | 17 | / | /
18 | 1 | 1 | 18 | /RelayOutputs/ | /58ADF524/
19 | 1 | 1 | 19 | /RelayOutputs/ | /58ADF524/
20 | 1 | 1 | 20 | /RelayOutputs/ | /58ADF524/
21 | 1 | 1 | 21 | /RelayOutputs/ | /58ADF524/
22 | 1 | 1 | 22 | /RelayOutputs/ | /58ADF524/
23 | 1 | 1 | 23 | /RelayOutputs/ | /58ADF524/
24 | 1 | 1 | 24 | /RelayOutputs/ | /58ADF524/
25 | 1 | 1 | 25 | /RelayOutputs/ | /58ADF524/
26 | 1 | 1 | 26 | /RelayOutputs/ | /58ADF524/
27 | 1 | 1 | 27 | /RelayOutputs/ | /58ADF524/
28 | 1 | 1 | 28 | /RelayOutputs/ | /58ADF524/
29 | 1 | 1 | 29 | /RelayOutputs/ | /58ADF524/
30 | 1 | 1 | 30 | /RelayOutputs/ | /58ADF524/
31 | 1 | 1 | 31 | /RelayOutputs/ | /58ADF524/
32 | 1 | 1 | 32 | /RelayOutputs/ | /58ADF524/
33 | 1 | 1 | 33 | /RelayOutputs/ | /58ADF524/
34 | 1 | 1 | 34 | /RelayOutputs/ | /58ADF524/
35 | 1 | 1 | 35 | /RelayOutputs/ | /58ADF524/
36 | 1 | 1 | 36 | /RelayOutputs/ | /58ADF524/
37 | 1 | 1 | 37 | /RelayOutputs/ | /58ADF524/
38 | 1 | 1 | 38 | /RelayOutputs/ | /58ADF524/
39 | 1 | 1 | 39 | /RelayOutputs/ | /58ADF524/
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
113 | 1 | 1 | 113 | /Microcontroller/ | /58AFCC8D/
114 | 1 | 1 | 114 | /Microcontroller/ | /58AFCC8D/
115 | 1 | 1 | 115 | /Microcontroller/ | /58AFCC8D/
116 | 1 | 1 | 116 | /Microcontroller/ | /58AFCC8D/
117 | 1 | 1 | 117 | /Microcontroller/ | /58AFCC8D/

Sheet: Libpart
libpart_id | export_id | libparts_id | description | docs | fields | pins | lib | part | footprints
1 | 1 | 1 | TQFP44, 64k Flash, 4k SRAM, 2k EEPROM, JTAG | http://www.atmel.com/Images/doc2593.pdf |  |  | atmel | ATMEGA644-A
2 | 1 | 1 | Standard IDC10 Male Connector, ISP Kanda (STK200/300) |  |  |  | atmel | AVR-ISP-10
3 | 1 | 1 | Unpolarized capacitor |  |  |  | device | C
4 | 1 | 1 | Connector, single row, 01x02 |  |  |  | conn | CONN_01X02
5 | 1 | 1 | Connector, single row, 01x08 |  |  |  | conn | CONN_01X08
6 | 1 | 1 | Polarised capacitor |  |  |  | device | CP1
7 | 1 | 1 | Two pin crystal |  |  |  | device | Crystal
8 | 1 | 1 | Diode |  |  |  | device | D
9 | 1 | 1 | Schottky diode |  |  |  | device | D_Schottky
10 | 1 | 1 | Inductor |  |  |  | device | L
11 | 1 | 1 | LED generic |  |  |  | device | LED
12 | 1 | 1 | DIP-4, DC Optocoupler, Vce 35V, CTR 50% | http://www.us.liteon.com/downloads/LTV-817-827-847.PDF |  |  | opto | LTV-817
13 | 1 | 1 |  |  |  |  | mc34063a | MC34063A
14 | 1 | 1 |  |  |  |  | meisei-m4-24h | Meisei-m4-24h
15 | 1 | 1 |  |  |  |  | ControlCircuit-rescue | Q_NPN_BCE-RESCUE-ControlCircuit
16 | 1 | 1 | Resistor |  |  |  | device | R
17 | 1 | 1 |  |  |  |  | tft-proto-mi0283qt-9a | tft-proto-mi0283qt-9a

Sheet: Pin
pin_id | export_id | libparts_id | libpart_id | pins_id | num | name | type
1 | 1 | 1 | 1 | 1 | 1 | (PCINT13/MOSI)PB5 | BiDi
2 | 1 | 1 | 1 | 1 | 2 | (PCINT14/MISO)PB6 | BiDi
3 | 1 | 1 | 1 | 1 | 3 | (PCINT15/SCK)PB7 | BiDi
4 | 1 | 1 | 1 | 1 | 4 | ~RESET | input
5 | 1 | 1 | 1 | 1 | 5 | VCC | power_in
6 | 1 | 1 | 1 | 1 | 6 | GND | power_in
7 | 1 | 1 | 1 | 1 | 7 | XTAL2 | BiDi
8 | 1 | 1 | 1 | 1 | 8 | XTAL1 | BiDi
9 | 1 | 1 | 1 | 1 | 9 | (PCINT24/RXD0)PD0 | BiDi
10 | 1 | 1 | 1 | 1 | 10 | (PCINT25/TXD0)PD1 | BiDi
11 | 1 | 1 | 1 | 1 | 11 | (PCINT26/INT0)PD2 | BiDi
12 | 1 | 1 | 1 | 1 | 12 | (PCINT27/INT1)PD3 | BiDi
13 | 1 | 1 | 1 | 1 | 13 | (PCINT28/OC1B)PD4 | BiDi
14 | 1 | 1 | 1 | 1 | 14 | (PCINT294/OC1A)PD5 | BiDi
15 | 1 | 1 | 1 | 1 | 15 | (PCINT30/OC2B/ICP)PD6 | BiDi
16 | 1 | 1 | 1 | 1 | 16 | (PCINT31/OC2A)PD7 | BiDi
17 | 1 | 1 | 1 | 1 | 17 | VCC | power_in
18 | 1 | 1 | 1 | 1 | 18 | GND | power_in
19 | 1 | 1 | 1 | 1 | 19 | (PCINT16/SCL)PC0 | BiDi
20 | 1 | 1 | 1 | 1 | 20 | (PCINT17/SDA)PC1 | BiDi
21 | 1 | 1 | 1 | 1 | 21 | (PCINT18/TCK)PC2 | BiDi
22 | 1 | 1 | 1 | 1 | 22 | (PCINT19/TMS)PC3 | BiDi
23 | 1 | 1 | 1 | 1 | 23 | (PCINT20/TDO)PC4 | BiDi
24 | 1 | 1 | 1 | 1 | 24 | (PCINT21/TDI)PC5 | BiDi
25 | 1 | 1 | 1 | 1 | 25 | (PCINT22/TOSC1)PC6 | BiDi
26 | 1 | 1 | 1 | 1 | 26 | (PCINT23/TOSC2)PC7 | BiDi
27 | 1 | 1 | 1 | 1 | 27 | AVCC | power_in
28 | 1 | 1 | 1 | 1 | 28 | GND | power_in
29 | 1 | 1 | 1 | 1 | 29 | AREF | power_in
30 | 1 | 1 | 1 | 1 | 30 | (PCINT7/ADC7)PA7 | BiDi
31 | 1 | 1 | 1 | 1 | 31 | (PCINT6/ADC6)PA6 | BiDi
32 | 1 | 1 | 1 | 1 | 32 | (PCINT5/ADC5)PA5 | BiDi
33 | 1 | 1 | 1 | 1 | 33 | (PCINT4/ADC4)PA4 | BiDi
34 | 1 | 1 | 1 | 1 | 34 | (PCINT3/ADC3)PA3 | BiDi
35 | 1 | 1 | 1 | 1 | 35 | (PCINT2/ADC2)PA2 | BiDi
36 | 1 | 1 | 1 | 1 | 36 | (PCINT1/ADC1)PA1 | BiDi
37 | 1 | 1 | 1 | 1 | 37 | (PCINT0/ADC0)PA0 | BiDi
38 | 1 | 1 | 1 | 1 | 38 | VCC | power_in
39 | 1 | 1 | 1 | 1 | 39 | GND | power_in
40 | 1 | 1 | 1 | 1 | 40 | (PCINT8/T0/XCK)PB0 | BiDi
41 | 1 | 1 | 1 | 1 | 41 | (PCINT9/CLKO/T1)PB1 | BiDi
42 | 1 | 1 | 1 | 1 | 42 | (PCINT10/AIN0/INT2)PB2 | BiDi
43 | 1 | 1 | 1 | 1 | 43 | (PCINT11/AIN1/OC0A)PB3 | BiDi
44 | 1 | 1 | 1 | 1 | 44 | (PCINT12/OC0B/~SS~)PB4 | BiDi
45 | 1 | 1 | 2 | 1 | 1 | ~ | passive
46 | 1 | 1 | 2 | 1 | 2 | ~ | passive
47 | 1 | 1 | 2 | 1 | 3 | ~ | passive
48 | 1 | 1 | 2 | 1 | 4 | ~ | passive
49 | 1 | 1 | 2 | 1 | 5 | ~ | passive
50 | 1 | 1 | 2 | 1 | 6 | ~ | passive
51 | 1 | 1 | 2 | 1 | 7 | ~ | passive
52 | 1 | 1 | 2 | 1 | 8 | ~ | passive
53 | 1 | 1 | 2 | 1 | 9 | ~ | passive
54 | 1 | 1 | 2 | 1 | 10 | ~ | passive
55 | 1 | 1 | 3 | 1 | 1 | ~ | passive
56 | 1 | 1 | 3 | 1 | 2 | ~ | passive
57 | 1 | 1 | 4 | 1 | 1 | P1 | passive
58 | 1 | 1 | 4 | 1 | 2 | P2 | passive
59 | 1 | 1 | 5 | 1 | 1 | P1 | passive
60 | 1 | 1 | 5 | 1 | 2 | P2 | passive
61 | 1 | 1 | 5 | 1 | 3 | P3 | passive
62 | 1 | 1 | 5 | 1 | 4 | P4 | passive
63 | 1 | 1 | 5 | 1 | 5 | P5 | passive
64 | 1 | 1 | 5 | 1 | 6 | P6 | passive
65 | 1 | 1 | 5 | 1 | 7 | P7 | passive
66 | 1 | 1 | 5 | 1 | 8 | P8 | passive
67 | 1 | 1 | 6 | 1 | 1 | ~ | passive
68 | 1 | 1 | 6 | 1 | 2 | ~ | passive
69 | 1 | 1 | 7 | 1 | 1 | 1 | passive
70 | 1 | 1 | 7 | 1 | 2 | 2 | passive
71 | 1 | 1 | 8 | 1 | 1 | K | passive
72 | 1 | 1 | 8 | 1 | 2 | A | passive
73 | 1 | 1 | 9 | 1 | 1 | K | passive
74 | 1 | 1 | 9 | 1 | 2 | A | passive
75 | 1 | 1 | 10 | 1 | 1 | 1 | passive
76 | 1 | 1 | 10 | 1 | 2 | 2 | passive
77 | 1 | 1 | 11 | 1 | 1 | K | passive
78 | 1 | 1 | 11 | 1 | 2 | A | passive
79 | 1 | 1 | 12 | 1 | 1 | ~ | passive
80 | 1 | 1 | 12 | 1 | 2 | ~ | passive
81 | 1 | 1 | 12 | 1 | 3 | ~ | passive
82 | 1 | 1 | 12 | 1 | 4 | ~ | passive
83 | 1 | 1 | 13 | 1 | 1 | Switch_Collector | input
84 | 1 | 1 | 13 | 1 | 2 | Switch_Emitter | input
85 | 1 | 1 | 13 | 1 | 3 | Timing_Capacitor | input
86 | 1 | 1 | 13 | 1 | 4 | Grid | input
87 | 1 | 1 | 13 | 1 | 5 | Comp_Inv_Input | input
88 | 1 | 1 | 13 | 1 | 6 | Vcc | input
89 | 1 | 1 | 13 | 1 | 7 | Ipk_Sense | input
90 | 1 | 1 | 13 | 1 | 8 | Driver_Collector | input
91 | 1 | 1 | 14 | 1 | 1 | Coil1 | input
92 | 1 | 1 | 14 | 1 | 4 | T1common | input
93 | 1 | 1 | 14 | 1 | 6 | T1sel1 | input
94 | 1 | 1 | 14 | 1 | 8 | T1sel2 | input
95 | 1 | 1 | 14 | 1 | 9 | T2sel2 | input
96 | 1 | 1 | 14 | 1 | 11 | T2sel1 | input
97 | 1 | 1 | 14 | 1 | 13 | T2common | input
98 | 1 | 1 | 14 | 1 | 16 | Coil2 | input
99 | 1 | 1 | 15 | 1 | 1 | E | passive
100 | 1 | 1 | 15 | 1 | 2 | C | passive
101 | 1 | 1 | 15 | 1 | 3 | B | input
102 | 1 | 1 | 16 | 1 | 1 | ~ | passive
103 | 1 | 1 | 16 | 1 | 2 | ~ | passive
104 | 1 | 1 | 17 | 1 | 1 | LEDK | output
105 | 1 | 1 | 17 | 1 | 2 | LEDA | input
106 | 1 | 1 | 17 | 1 | 3 | IM0 | input
107 | 1 | 1 | 17 | 1 | 4 | IM3 | input
108 | 1 | 1 | 17 | 1 | 5 | IM2 | input
109 | 1 | 1 | 17 | 1 | 6 | IM1 | input
110 | 1 | 1 | 17 | 1 | 7 | RST | input
111 | 1 | 1 | 17 | 1 | 8 | DB17 | input
112 | 1 | 1 | 17 | 1 | 9 | DB16 | input
113 | 1 | 1 | 17 | 1 | 10 | DB15 | input
114 | 1 | 1 | 17 | 1 | 11 | DB14 | input
115 | 1 | 1 | 17 | 1 | 12 | DB13 | input
116 | 1 | 1 | 17 | 1 | 13 | DB12 | input
117 | 1 | 1 | 17 | 1 | 14 | DB11 | input
118 | 1 | 1 | 17 | 1 | 15 | DB10 | input
119 | 1 | 1 | 17 | 1 | 16 | DB9 | input
120 | 1 | 1 | 17 | 1 | 17 | DB8 | input
121 | 1 | 1 | 17 | 1 | 18 | DB7 | input
122 | 1 | 1 | 17 | 1 | 19 | DB6 | input
123 | 1 | 1 | 17 | 1 | 20 | DB5 | input
124 | 1 | 1 | 17 | 1 | 21 | DB4 | input
125 | 1 | 1 | 17 | 1 | 22 | DB3 | input
126 | 1 | 1 | 17 | 1 | 23 | DB2 | input
127 | 1 | 1 | 17 | 1 | 24 | DB1 | input
128 | 1 | 1 | 17 | 1 | 25 | DB0 | input
129 | 1 | 1 | 17 | 1 | 26 | GND | input
130 | 1 | 1 | 17 | 1 | 27 | SDO | input
131 | 1 | 1 | 17 | 1 | 28 | SDI | input
132 | 1 | 1 | 17 | 1 | 29 | RD | input
133 | 1 | 1 | 17 | 1 | 30 | WR | input
134 | 1 | 1 | 17 | 1 | 31 | RS | input
135 | 1 | 1 | 17 | 1 | 32 | CS | input
136 | 1 | 1 | 17 | 1 | 33 | TE | input
137 | 1 | 1 | 17 | 1 | 34 | GND | input
138 | 1 | 1 | 17 | 1 | 35 | X+ | output
139 | 1 | 1 | 17 | 1 | 36 | Y+ | output
140 | 1 | 1 | 17 | 1 | 37 | X- | output
141 | 1 | 1 | 17 | 1 | 38 | Y- | output
142 | 1 | 1 | 17 | 1 | 39 | 3.3V | output
143 | 1 | 1 | 17 | 1 | 40 | GND | input

Sheet: Library
library_id | export_id | libraries_id | uri | logical
1 | 1 | 1 | C:\Program Files\KiCad\share\kicad\library\device.lib | device
2 | 1 | 1 | ControlCircuit-rescue.lib | ControlCircuit-rescue
3 | 1 | 1 | tft-proto-mi0283qt-9a.lib | tft-proto-mi0283qt-9a
4 | 1 | 1 | meisei-m4-24h.lib | meisei-m4-24h
5 | 1 | 1 | mc34063a.lib | mc34063a
6 | 1 | 1 | C:\Program Files\KiCad\share\kicad\library\conn.lib | conn
7 | 1 | 1 | C:\Program Files\KiCad\share\kicad\library\opto.lib | opto
8 | 1 | 1 | C:\Program Files\KiCad\share\kicad\library\atmel.lib | atmel

Sheet: Net
net_id | export_id | nets_id | code | name
1 | 1 | 1 | 1 | /RelayInputs/I2
2 | 1 | 1 | 2 | /RelayOutputs/O7
3 | 1 | 1 | 3 | /RelayOutputs/O8
4 | 1 | 1 | 4 | /RelayInputs/I8
5 | 1 | 1 | 5 | /RelayInputs/I7
6 | 1 | 1 | 6 | /RelayInputs/I6
7 | 1 | 1 | 7 | /RelayInputs/I5
8 | 1 | 1 | 8 | /RelayInputs/I4
9 | 1 | 1 | 9 | /RelayInputs/I3
10 | 1 | 1 | 10 | /RelayInputs/I1
11 | 1 | 1 | 11 | /LCDTouchScreen/WR
12 | 1 | 1 | 12 | /LCDTouchScreen/CS
13 | 1 | 1 | 13 | /LCDTouchScreen/RST
14 | 1 | 1 | 14 | /Microcontroller/ADC3
15 | 1 | 1 | 15 | /Microcontroller/ADC2
16 | 1 | 1 | 16 | /Microcontroller/ADC1
17 | 1 | 1 | 17 | /Microcontroller/ADC0
18 | 1 | 1 | 18 | /LCDTouchScreen/SCK
19 | 1 | 1 | 19 | /RelayOutputs/O3
20 | 1 | 1 | 20 | /RelayOutputs/OR2com
21 | 1 | 1 | 21 | /RelayOutputs/OR1sel2
22 | 1 | 1 | 22 | /RelayOutputs/OR1sel1
23 | 1 | 1 | 23 | /RelayOutputs/OR1com
24 | 1 | 1 | 24 | /RelayOutputs/O1
25 | 1 | 1 | 25 | /RelayOutputs/O2
26 | 1 | 1 | 26 | /LCDTouchScreen/MISO
27 | 1 | 1 | 27 | /RelayOutputs/O4
28 | 1 | 1 | 28 | /RelayOutputs/O5
29 | 1 | 1 | 29 | /RelayOutputs/O6
30 | 1 | 1 | 30 | Net-(R103-Pad2)
31 | 1 | 1 | 31 | /Microcontroller/AREF
32 | 1 | 1 | 32 | /RelayInputs/RI8K
33 | 1 | 1 | 33 | /RelayInputs/RI8A
34 | 1 | 1 | 34 | /RelayInputs/RI7K
35 | 1 | 1 | 35 | /RelayInputs/RI7A
36 | 1 | 1 | 36 | /RelayInputs/RI6K
37 | 1 | 1 | 37 | /RelayInputs/RI6A
38 | 1 | 1 | 38 | /RelayInputs/RI5K
39 | 1 | 1 | 39 | /RelayInputs/RI5A
40 | 1 | 1 | 40 | /OR6s2
41 | 1 | 1 | 41 | Net-(C102-Pad2)
42 | 1 | 1 | 42 | /LCDTouchScreen/MOSI
43 | 1 | 1 | 43 | Net-(R101-Pad1)
44 | 1 | 1 | 44 | Net-(L101-Pad2)
45 | 1 | 1 | 45 | +3V3
46 | 1 | 1 | 46 | +24V
47 | 1 | 1 | 47 | /PB3
48 | 1 | 1 | 48 | /PB4
49 | 1 | 1 | 49 | /Microcontroller/ADC4
50 | 1 | 1 | 50 | /Microcontroller/ADC5
51 | 1 | 1 | 51 | /Microcontroller/ADC6
52 | 1 | 1 | 52 | /Microcontroller/ADC7
53 | 1 | 1 | 53 | /RelayInputs/RI4K
54 | 1 | 1 | 54 | /RelayInputs/RI4A
55 | 1 | 1 | 55 | /RelayInputs/RI3K
56 | 1 | 1 | 56 | /RelayInputs/RI3A
57 | 1 | 1 | 57 | /RelayInputs/RI2K
58 | 1 | 1 | 58 | /RelayInputs/RI2A
59 | 1 | 1 | 59 | /RelayInputs/RI1K
60 | 1 | 1 | 60 | /RelayInputs/RI1A
61 | 1 | 1 | 61 | Net-(D102-Pad2)
62 | 1 | 1 | 62 | GND
63 | 1 | 1 | 63 | /RelayOutputs/OR6com
64 | 1 | 1 | 64 | /RelayOutputs/OR7sel1
65 | 1 | 1 | 65 | /RelayOutputs/OR8sel1
66 | 1 | 1 | 66 | /RelayOutputs/OR3com
67 | 1 | 1 | 67 | /RelayOutputs/OR2sel2
68 | 1 | 1 | 68 | /RelayOutputs/OR5sel2
69 | 1 | 1 | 69 | /RelayOutputs/OR3sel2
70 | 1 | 1 | 70 | /RelayOutputs/OR3sel1
71 | 1 | 1 | 71 | /RelayOutputs/OR2sel1
72 | 1 | 1 | 72 | /RelayOutputs/OR4com
73 | 1 | 1 | 73 | /OR6s1
74 | 1 | 1 | 74 | /OR7s2
75 | 1 | 1 | 75 | /OR7c
76 | 1 | 1 | 76 | /OR8s2
77 | 1 | 1 | 77 | /OR8c
78 | 1 | 1 | 78 | /RelayOutputs/OR4sel1
79 | 1 | 1 | 79 | /RelayOutputs/OR4sel2
80 | 1 | 1 | 80 | /RelayOutputs/OR5com
81 | 1 | 1 | 81 | /RelayOutputs/OR5sel1
82 | 1 | 1 | 82 | Net-(Q208-Pad3)
83 | 1 | 1 | 83 | Net-(K208-Pad13)
84 | 1 | 1 | 84 | Net-(K208-Pad11)
85 | 1 | 1 | 85 | Net-(K208-Pad9)
86 | 1 | 1 | 86 | Net-(D209-Pad1)
87 | 1 | 1 | 87 | Net-(D209-Pad2)
88 | 1 | 1 | 88 | Net-(D212-Pad1)
89 | 1 | 1 | 89 | Net-(K207-Pad9)
90 | 1 | 1 | 90 | Net-(K207-Pad11)
91 | 1 | 1 | 91 | Net-(K207-Pad13)
92 | 1 | 1 | 92 | Net-(Q207-Pad3)
93 | 1 | 1 | 93 | Net-(D201-Pad2)
94 | 1 | 1 | 94 | Net-(D202-Pad2)
95 | 1 | 1 | 95 | Net-(D210-Pad2)
96 | 1 | 1 | 96 | Net-(D212-Pad2)
97 | 1 | 1 | 97 | Net-(Q202-Pad3)
98 | 1 | 1 | 98 | Net-(Q201-Pad3)
99 | 1 | 1 | 99 | Net-(Q205-Pad3)
100 | 1 | 1 | 100 | Net-(Q206-Pad3)
101 | 1 | 1 | 101 | Net-(D203-Pad2)
102 | 1 | 1 | 102 | Net-(D211-Pad2)
103 | 1 | 1 | 103 | Net-(D204-Pad2)
104 | 1 | 1 | 104 | Net-(Q204-Pad3)
105 | 1 | 1 | 105 | Net-(Q203-Pad3)
106 | 1 | 1 | 106 | Net-(K206-Pad13)
107 | 1 | 1 | 107 | Net-(K206-Pad11)
108 | 1 | 1 | 108 | Net-(K206-Pad9)
109 | 1 | 1 | 109 | Net-(D210-Pad1)
110 | 1 | 1 | 110 | Net-(K201-Pad13)
111 | 1 | 1 | 111 | Net-(K201-Pad11)
112 | 1 | 1 | 112 | Net-(K201-Pad9)
113 | 1 | 1 | 113 | Net-(D211-Pad1)
114 | 1 | 1 | 114 | Net-(D204-Pad1)
115 | 1 | 1 | 115 | Net-(K204-Pad9)
116 | 1 | 1 | 116 | Net-(K204-Pad11)
117 | 1 | 1 | 117 | Net-(K204-Pad13)
118 | 1 | 1 | 118 | Net-(K205-Pad13)
119 | 1 | 1 | 119 | Net-(K205-Pad9)
120 | 1 | 1 | 120 | Net-(K205-Pad11)
121 | 1 | 1 | 121 | Net-(K203-Pad13)
122 | 1 | 1 | 122 | Net-(D203-Pad1)
123 | 1 | 1 | 123 | Net-(K203-Pad9)
124 | 1 | 1 | 124 | Net-(K203-Pad11)
125 | 1 | 1 | 125 | Net-(K202-Pad13)
126 | 1 | 1 | 126 | Net-(K202-Pad11)
127 | 1 | 1 | 127 | Net-(K202-Pad9)
128 | 1 | 1 | 128 | Net-(D201-Pad1)
129 | 1 | 1 | 129 | Net-(D202-Pad1)
130 | 1 | 1 | 130 | Net-(D307-Pad2)
131 | 1 | 1 | 131 | Net-(D305-Pad2)
132 | 1 | 1 | 132 | Net-(D303-Pad1)
133 | 1 | 1 | 133 | Net-(D304-Pad1)
134 | 1 | 1 | 134 | Net-(D315-Pad2)
135 | 1 | 1 | 135 | Net-(D316-Pad2)
136 | 1 | 1 | 136 | Net-(D314-Pad2)
137 | 1 | 1 | 137 | Net-(D306-Pad2)
138 | 1 | 1 | 138 | Net-(D308-Pad2)
139 | 1 | 1 | 139 | Net-(D313-Pad2)
140 | 1 | 1 | 140 | Net-(D311-Pad1)
141 | 1 | 1 | 141 | Net-(D309-Pad1)
142 | 1 | 1 | 142 | Net-(D310-Pad1)
143 | 1 | 1 | 143 | Net-(D302-Pad1)
144 | 1 | 1 | 144 | Net-(D312-Pad1)
145 | 1 | 1 | 145 | Net-(D301-Pad1)
146 | 1 | 1 | 146 | Net-(LCD401-Pad2)
147 | 1 | 1 | 147 | Net-(C509-Pad2)
148 | 1 | 1 | 148 | Net-(CON501-Pad3)
149 | 1 | 1 | 149 | /Microcontroller/RESET
150 | 1 | 1 | 150 | Net-(C501-Pad1)
151 | 1 | 1 | 151 | Net-(C502-Pad1)

Sheet: Node
node_id | export_id | nets_id | net_id | ref | pin
1 | 1 | 1 | 1 | IC501 | 10
2 | 1 | 1 | 1 | U302 | 4
3 | 1 | 1 | 1 | D306 | 1
4 | 1 | 1 | 2 | IC501 | 20
5 | 1 | 1 | 2 | R212 | 1
6 | 1 | 1 | 3 | R209 | 1
7 | 1 | 1 | 3 | IC501 | 19
8 | 1 | 1 | 4 | IC501 | 16
9 | 1 | 1 | 4 | U308 | 4
10 | 1 | 1 | 4 | D316 | 1
11 | 1 | 1 | 5 | U307 | 4
12 | 1 | 1 | 5 | IC501 | 15
13 | 1 | 1 | 5 | D315 | 1
14 | 1 | 1 | 6 | U306 | 4
15 | 1 | 1 | 6 | IC501 | 14
16 | 1 | 1 | 6 | D314 | 1
17 | 1 | 1 | 7 | D313 | 1
18 | 1 | 1 | 7 | IC501 | 13
19 | 1 | 1 | 7 | U305 | 4
20 | 1 | 1 | 8 | D308 | 1
21 | 1 | 1 | 8 | U304 | 4
22 | 1 | 1 | 8 | IC501 | 12
23 | 1 | 1 | 9 | IC501 | 11
24 | 1 | 1 | 9 | U303 | 4
25 | 1 | 1 | 9 | D307 | 1
26 | 1 | 1 | 10 | IC501 | 9
27 | 1 | 1 | 10 | D305 | 1
28 | 1 | 1 | 10 | U301 | 4
29 | 1 | 1 | 11 | LCD401 | 30
30 | 1 | 1 | 11 | IC501 | 41
31 | 1 | 1 | 12 | IC501 | 42
32 | 1 | 1 | 12 | LCD401 | 32
33 | 1 | 1 | 13 | LCD401 | 7
34 | 1 | 1 | 13 | IC501 | 40
35 | 1 | 1 | 14 | IC501 | 37
36 | 1 | 1 | 14 | LCD401 | 38
37 | 1 | 1 | 15 | LCD401 | 37
38 | 1 | 1 | 15 | IC501 | 36
39 | 1 | 1 | 16 | IC501 | 35
40 | 1 | 1 | 16 | LCD401 | 36
41 | 1 | 1 | 17 | LCD401 | 35
42 | 1 | 1 | 17 | IC501 | 34
43 | 1 | 1 | 18 | IC501 | 3
44 | 1 | 1 | 18 | CON501 | 7
45 | 1 | 1 | 18 | LCD401 | 31
46 | 1 | 1 | 19 | IC501 | 24
47 | 1 | 1 | 19 | R203 | 2
48 | 1 | 1 | 20 | K202 | 4
49 | 1 | 1 | 20 | P105 | 5
50 | 1 | 1 | 21 | K201 | 8
51 | 1 | 1 | 21 | P105 | 6
52 | 1 | 1 | 22 | K201 | 6
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
409 | 1 | 1 | 141 | D309 | 1
410 | 1 | 1 | 141 | R309 | 1
411 | 1 | 1 | 142 | U306 | 1
412 | 1 | 1 | 142 | D310 | 1
413 | 1 | 1 | 142 | R310 | 1
414 | 1 | 1 | 143 | R302 | 1
415 | 1 | 1 | 143 | U302 | 1
416 | 1 | 1 | 143 | D302 | 1
417 | 1 | 1 | 144 | D312 | 1
418 | 1 | 1 | 144 | R312 | 1
419 | 1 | 1 | 144 | U308 | 1
420 | 1 | 1 | 145 | U301 | 1
421 | 1 | 1 | 145 | D301 | 1
422 | 1 | 1 | 145 | R301 | 1
423 | 1 | 1 | 146 | R401 | 1
424 | 1 | 1 | 146 | LCD401 | 2
425 | 1 | 1 | 147 | L501 | 2
426 | 1 | 1 | 147 | IC501 | 27
427 | 1 | 1 | 147 | C509 | 2
428 | 1 | 1 | 148 | CON501 | 3
429 | 1 | 1 | 149 | IC501 | 4
430 | 1 | 1 | 149 | CON501 | 5
431 | 1 | 1 | 150 | C501 | 1
432 | 1 | 1 | 150 | Y501 | 1
433 | 1 | 1 | 150 | IC501 | 7
434 | 1 | 1 | 151 | C502 | 1
435 | 1 | 1 | 151 | IC501 | 8
436 | 1 | 1 | 151 | Y501 | 2
