Simmz64/EmbeddedProject/GUI_test.bmp

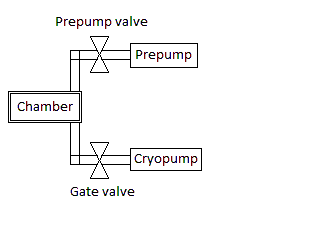
GUI_test.bmp
