Simmz64/EmbeddedProject/Circuit/ControlCircuit-B.Cu.pdf

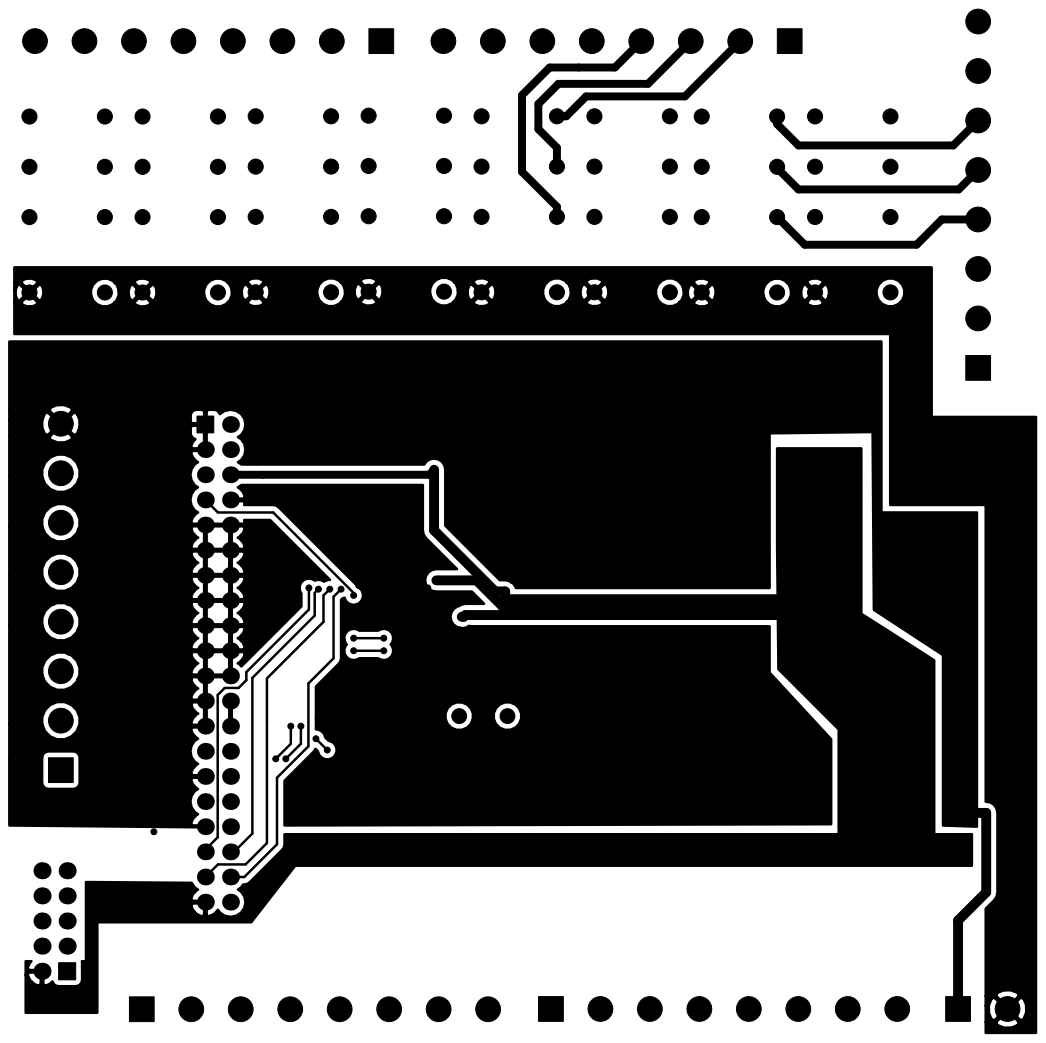
[picture p44: page 1]
