Simmz64/EmbeddedProject/Circuit/ControlCircuit-F.Cu.pdf

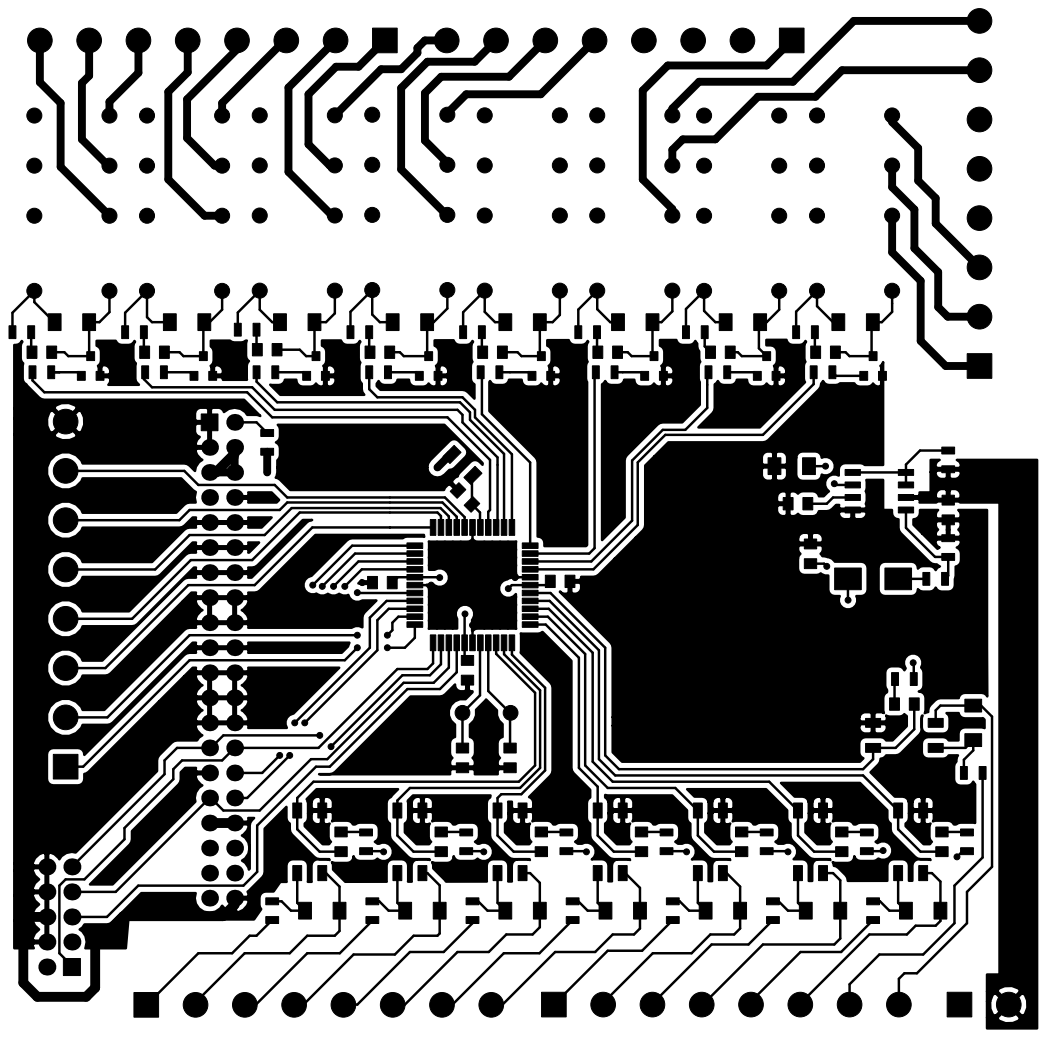
[picture p45: page 1]
