Simmz64/EmbeddedProject/Circuit/ControlCircuit-F.SilkS.pdf

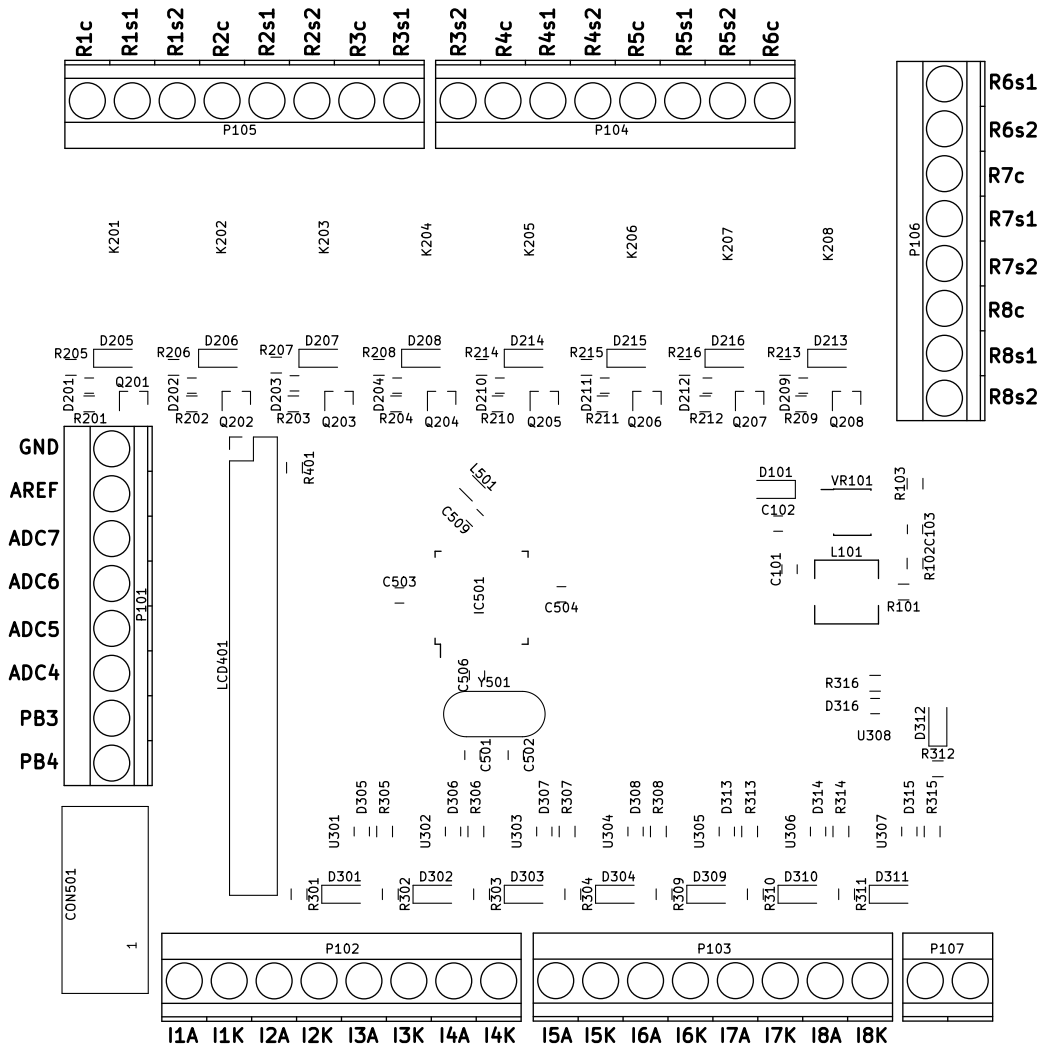
[picture p46: page 1]
