Simmz64/EmbeddedProject/(list of files, drawings)

Other design files:
Circuit/ControlCircuit.dsn
