Simmz64/EmbeddedProject/Circuit/ControlCircuit.kicad_pcb

## KiCad design Circuit/ControlCircuit.kicad_pcb (2017-03-16)

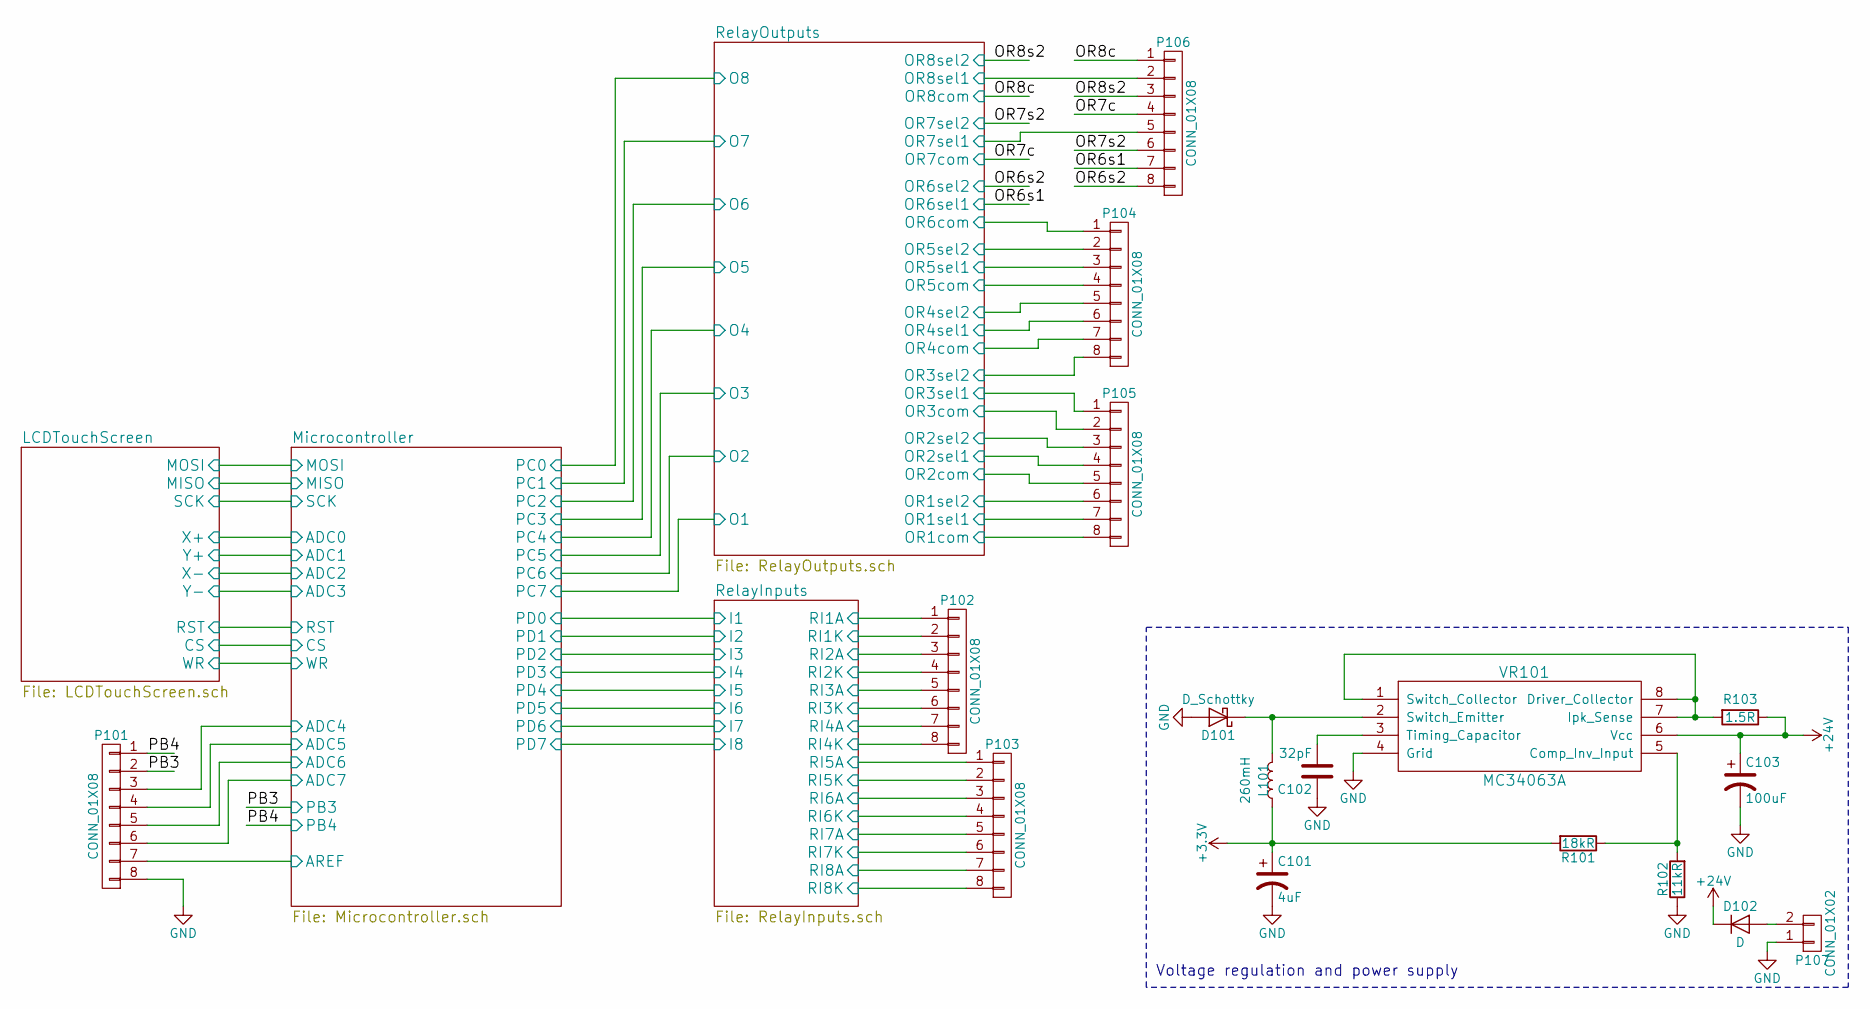
[picture p47: schematic ControlCircuit.sch]

Parts:
C101: 4uF; C_1206
C102: 32pF; C_0805
C103: 100uF; C_0805
D101: D_Schottky; D_MiniMELF_Standard
D102: D; D_MELF_Standard
L101: 260mH; Inductor_Wurth_HCI-7050
P101, P102, P103, P104, P105, P106: CONN_01X08; TerminalBlock_Pheonix_MKDS1.5-8pol
P107: CONN_01X02; TerminalBlock_Pheonix_MKDS1.5-2pol
R101: 18kR; R_0805
R102: 11kR; R_0805
R103: 1.5R; R_0805
VR101: MC34063A; SOIC-8_3.9x4.9mm_Pitch1.27mm

Connections:
+3V3: C101.1, L101.1, R101.2; also elsewhere on the board
+24V: C103.1, D102.1 (K), R103.1, VR101.6 (Vcc); also elsewhere on the board
/Microcontroller/ADC4: P101.3; also elsewhere on the board
/Microcontroller/ADC5: P101.4; also elsewhere on the board
/Microcontroller/ADC6: P101.5; also elsewhere on the board
/Microcontroller/ADC7: P101.6; also elsewhere on the board
/Microcontroller/AREF: P101.7; also elsewhere on the board
/OR6s1: P106.7; also elsewhere on the board
/OR6s2: P106.8; also elsewhere on the board
/OR7c: P106.4; also elsewhere on the board
/OR7s2: P106.6; also elsewhere on the board
/OR8c: P106.1; also elsewhere on the board
/OR8s2: P106.3; also elsewhere on the board
/PB3: P101.2; also elsewhere on the board
/PB4: P101.1; also elsewhere on the board
/RelayInputs/RI1A: P102.1; also elsewhere on the board
/RelayInputs/RI1K: P102.2; also elsewhere on the board
/RelayInputs/RI2A: P102.3; also elsewhere on the board
/RelayInputs/RI2K: P102.4; also elsewhere on the board
/RelayInputs/RI3A: P102.5; also elsewhere on the board
/RelayInputs/RI3K: P102.6; also elsewhere on the board
/RelayInputs/RI4A: P102.7; also elsewhere on the board
/RelayInputs/RI4K: P102.8; also elsewhere on the board
/RelayInputs/RI5A: P103.1; also elsewhere on the board
/RelayInputs/RI5K: P103.2; also elsewhere on the board
/RelayInputs/RI6A: P103.3; also elsewhere on the board
/RelayInputs/RI6K: P103.4; also elsewhere on the board
/RelayInputs/RI7A: P103.5; also elsewhere on the board
/RelayInputs/RI7K: P103.6; also elsewhere on the board
/RelayInputs/RI8A: P103.7; also elsewhere on the board
/RelayInputs/RI8K: P103.8; also elsewhere on the board
/RelayOutputs/OR1com: P105.8; also elsewhere on the board
/RelayOutputs/OR1sel1: P105.7; also elsewhere on the board
/RelayOutputs/OR1sel2: P105.6; also elsewhere on the board
/RelayOutputs/OR2com: P105.5; also elsewhere on the board
/RelayOutputs/OR2sel1: P105.4; also elsewhere on the board
/RelayOutputs/OR2sel2: P105.3; also elsewhere on the board
/RelayOutputs/OR3com: P105.2; also elsewhere on the board
/RelayOutputs/OR3sel1: P105.1; also elsewhere on the board
/RelayOutputs/OR3sel2: P104.8; also elsewhere on the board
/RelayOutputs/OR4com: P104.7; also elsewhere on the board
/RelayOutputs/OR4sel1: P104.6; also elsewhere on the board
/RelayOutputs/OR4sel2: P104.5; also elsewhere on the board
/RelayOutputs/OR5com: P104.4; also elsewhere on the board
/RelayOutputs/OR5sel1: P104.3; also elsewhere on the board
/RelayOutputs/OR5sel2: P104.2; also elsewhere on the board
/RelayOutputs/OR6com: P104.1; also elsewhere on the board
/RelayOutputs/OR7sel1: P106.5; also elsewhere on the board
/RelayOutputs/OR8sel1: P106.2; also elsewhere on the board
GND: C101.2, C102.1, C103.2, D101.2 (A), P101.8, P107.1, R102.1, VR101.4 (Grid); also elsewhere on the board
unnamed: C102.2, VR101.3 (Timing_Capacitor)
unnamed: D101.1 (K), L101.2, VR101.2 (Switch_Emitter)
unnamed: D102.2 (A), P107.2
unnamed: R101.1, R102.2, VR101.5 (Comp_Inv_Input)
unnamed: R103.2, VR101.1 (Switch_Collector), VR101.7 (Ipk_Sense), VR101.8 (Driver_Collector)

Notes on the sheet:
Voltage regulation and power supply

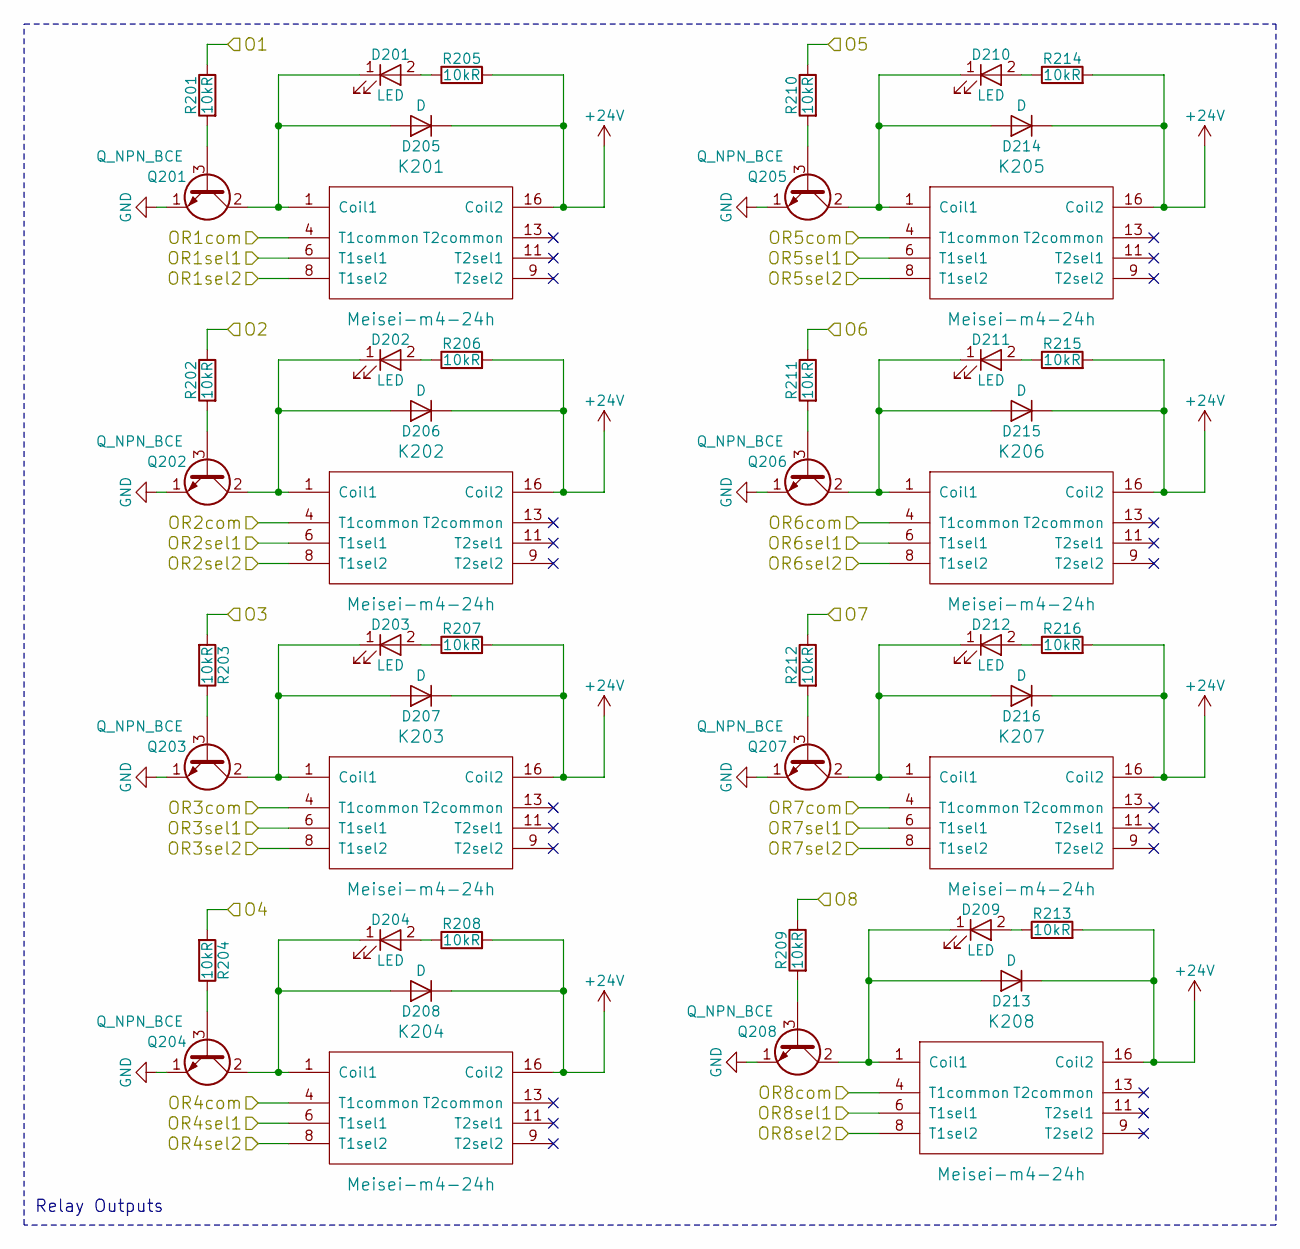
[picture p48: schematic RelayOutputs.sch]

Parts:
D201, D202, D203, D204, D209, D210, D211, D212: LED; C_0805
D205, D206, D207, D208, D213, D214, D215, D216: D; D_MiniMELF_Standard
K201, K202, K203, K204, K205, K206, K207, K208: Meisei-m4-24h
Q201, Q202, Q203, Q204, Q205, Q206, Q207, Q208: Q_NPN_BCE; MMBT3904
R201, R202, R203, R204, R205, R206, R207, R208, R209, R210, R211, R212, R213, R214, R215, R216: 10kR; R_0805

Connections:
+24V: D205.1 (K), D206.1 (K), D207.1 (K), D208.1 (K), D213.1 (K), D214.1 (K), D215.1 (K), D216.1 (K), K201.16 (Coil2), K202.16 (Coil2), K203.16 (Coil2), K204.16 (Coil2), K205.16 (Coil2), K206.16 (Coil2), K207.16 (Coil2), K208.16 (Coil2), R205.2, R206.2, R207.2, R208.2, R213.2, R214.2, R215.2, R216.2; also elsewhere on the board
/OR6s1: K206.6 (T1sel1); also elsewhere on the board
/OR6s2: K206.8 (T1sel2); also elsewhere on the board
/OR7c: K207.4 (T1common); also elsewhere on the board
/OR7s2: K207.8 (T1sel2); also elsewhere on the board
/OR8c: K208.4 (T1common); also elsewhere on the board
/OR8s2: K208.8 (T1sel2); also elsewhere on the board
/RelayOutputs/O1: R201.1; also elsewhere on the board
/RelayOutputs/O2: R202.1; also elsewhere on the board
/RelayOutputs/O3: R203.2; also elsewhere on the board
/RelayOutputs/O4: R204.2; also elsewhere on the board
/RelayOutputs/O5: R210.1; also elsewhere on the board
/RelayOutputs/O6: R211.1; also elsewhere on the board
/RelayOutputs/O7: R212.1; also elsewhere on the board
/RelayOutputs/O8: R209.1; also elsewhere on the board
/RelayOutputs/OR1com: K201.4 (T1common); also elsewhere on the board
/RelayOutputs/OR1sel1: K201.6 (T1sel1); also elsewhere on the board
/RelayOutputs/OR1sel2: K201.8 (T1sel2); also elsewhere on the board
/RelayOutputs/OR2com: K202.4 (T1common); also elsewhere on the board
/RelayOutputs/OR2sel1: K202.6 (T1sel1); also elsewhere on the board
/RelayOutputs/OR2sel2: K202.8 (T1sel2); also elsewhere on the board
/RelayOutputs/OR3com: K203.4 (T1common); also elsewhere on the board
/RelayOutputs/OR3sel1: K203.6 (T1sel1); also elsewhere on the board
/RelayOutputs/OR3sel2: K203.8 (T1sel2); also elsewhere on the board
/RelayOutputs/OR4com: K204.4 (T1common); also elsewhere on the board
/RelayOutputs/OR4sel1: K204.6 (T1sel1); also elsewhere on the board
/RelayOutputs/OR4sel2: K204.8 (T1sel2); also elsewhere on the board
/RelayOutputs/OR5com: K205.4 (T1common); also elsewhere on the board
/RelayOutputs/OR5sel1: K205.6 (T1sel1); also elsewhere on the board
/RelayOutputs/OR5sel2: K205.8 (T1sel2); also elsewhere on the board
/RelayOutputs/OR6com: K206.4 (T1common); also elsewhere on the board
/RelayOutputs/OR7sel1: K207.6 (T1sel1); also elsewhere on the board
/RelayOutputs/OR8sel1: K208.6 (T1sel1); also elsewhere on the board
GND: Q201.1 (E), Q202.1 (E), Q203.1 (E), Q204.1 (E), Q205.1 (E), Q206.1 (E), Q207.1 (E), Q208.1 (E); also elsewhere on the board
unnamed: D201.1 (K), D205.2 (A), K201.1 (Coil1), Q201.2 (C)
unnamed: D201.2 (A), R205.1
unnamed: D202.1 (K), D206.2 (A), K202.1 (Coil1), Q202.2 (C)
unnamed: D202.2 (A), R206.1
unnamed: D203.1 (K), D207.2 (A), K203.1 (Coil1), Q203.2 (C)
unnamed: D203.2 (A), R207.1
unnamed: D204.1 (K), D208.2 (A), K204.1 (Coil1), Q204.2 (C)
unnamed: D204.2 (A), R208.1
unnamed: D209.1 (K), D213.2 (A), K208.1 (Coil1), Q208.2 (C)
unnamed: D209.2 (A), R213.1
unnamed: D210.1 (K), D214.2 (A), K205.1 (Coil1), Q205.2 (C)
unnamed: D210.2 (A), R214.1
unnamed: D211.1 (K), D215.2 (A), K206.1 (Coil1), Q206.2 (C)
unnamed: D211.2 (A), R215.1
unnamed: D212.1 (K), D216.2 (A), K207.1 (Coil1), Q207.2 (C)
unnamed: D212.2 (A), R216.1
unnamed: Q201.3 (B), R201.2
unnamed: Q202.3 (B), R202.2
unnamed: Q203.3 (B), R203.1
unnamed: Q204.3 (B), R204.1
unnamed: Q205.3 (B), R210.2
unnamed: Q206.3 (B), R211.2
unnamed: Q207.3 (B), R212.2
unnamed: Q208.3 (B), R209.2

Notes on the sheet:
Relay Outputs

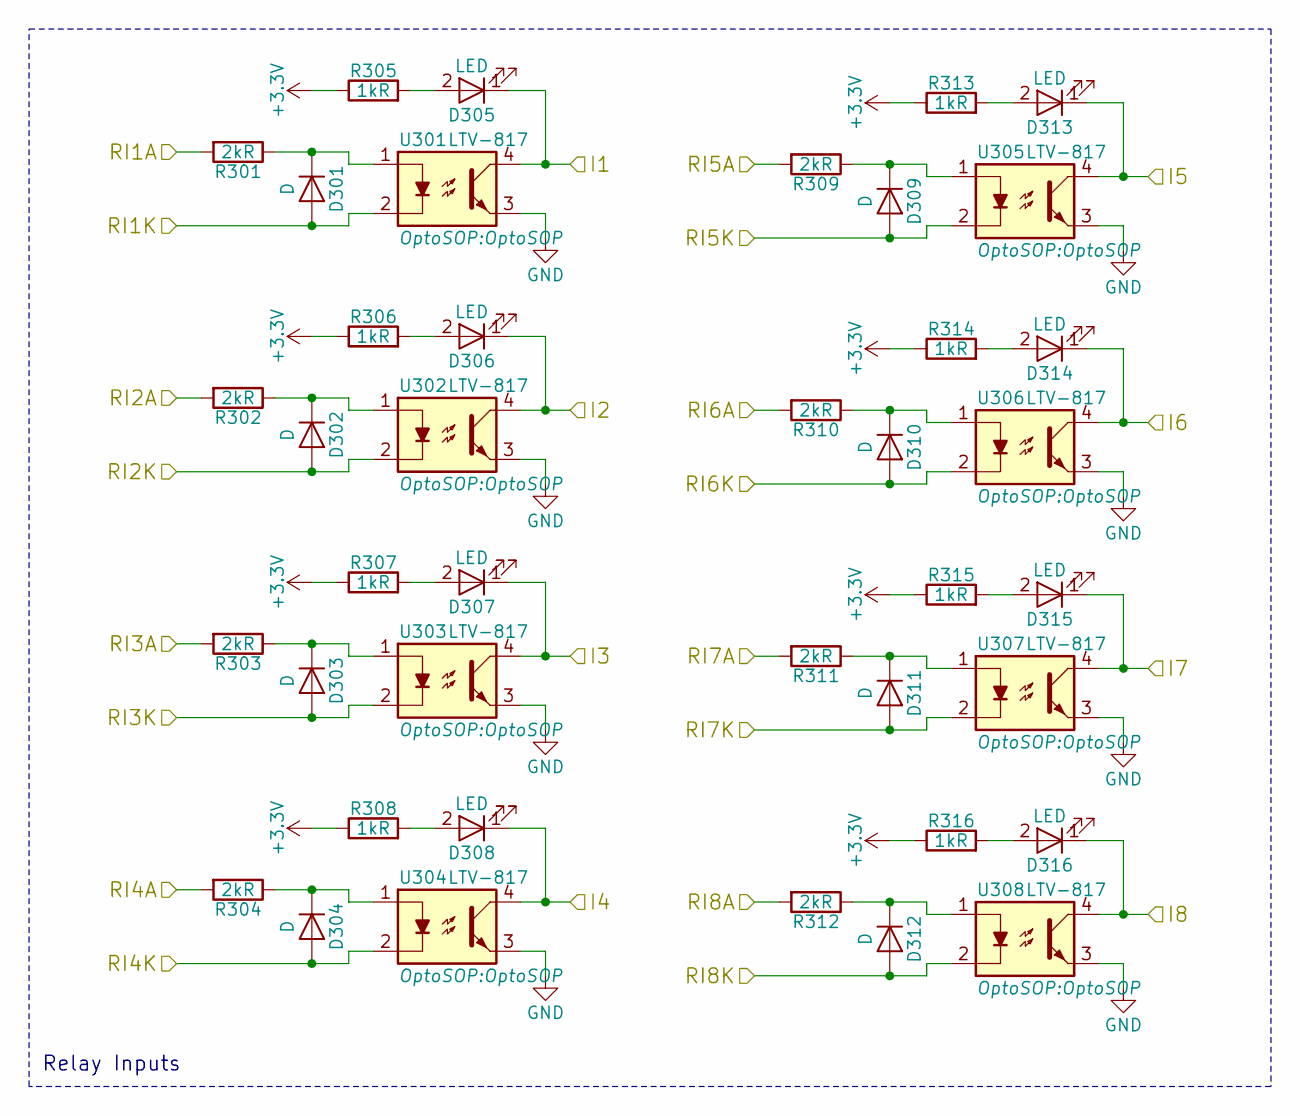
[picture p49: schematic RelayInputs.sch]

Parts:
D301, D302, D303, D304, D309, D310, D311, D312: D; D_MiniMELF_Standard
D305, D306, D307, D308, D313, D314, D315, D316: LED; C_0805
R301, R302, R303, R304, R309, R310, R311, R312: 2kR; R_0805
R305, R306, R307, R308, R313, R314, R315, R316: 1kR; R_0805
U301, U302, U303, U304, U305, U306, U307, U308: LTV-817; OptoSOP

Connections:
+3V3: R305.1, R306.1, R307.1, R308.1, R313.1, R314.1, R315.1, R316.1; also elsewhere on the board
/RelayInputs/I1: D305.1 (K), U301.4; also elsewhere on the board
/RelayInputs/I2: D306.1 (K), U302.4; also elsewhere on the board
/RelayInputs/I3: D307.1 (K), U303.4; also elsewhere on the board
/RelayInputs/I4: D308.1 (K), U304.4; also elsewhere on the board
/RelayInputs/I5: D313.1 (K), U305.4; also elsewhere on the board
/RelayInputs/I6: D314.1 (K), U306.4; also elsewhere on the board
/RelayInputs/I7: D315.1 (K), U307.4; also elsewhere on the board
/RelayInputs/I8: D316.1 (K), U308.4; also elsewhere on the board
/RelayInputs/RI1A: R301.2; also elsewhere on the board
/RelayInputs/RI1K: D301.2 (A), U301.2; also elsewhere on the board
/RelayInputs/RI2A: R302.2; also elsewhere on the board
/RelayInputs/RI2K: D302.2 (A), U302.2; also elsewhere on the board
/RelayInputs/RI3A: R303.2; also elsewhere on the board
/RelayInputs/RI3K: D303.2 (A), U303.2; also elsewhere on the board
/RelayInputs/RI4A: R304.2; also elsewhere on the board
/RelayInputs/RI4K: D304.2 (A), U304.2; also elsewhere on the board
/RelayInputs/RI5A: R309.2; also elsewhere on the board
/RelayInputs/RI5K: D309.2 (A), U305.2; also elsewhere on the board
/RelayInputs/RI6A: R310.2; also elsewhere on the board
/RelayInputs/RI6K: D310.2 (A), U306.2; also elsewhere on the board
/RelayInputs/RI7A: R311.2; also elsewhere on the board
/RelayInputs/RI7K: D311.2 (A), U307.2; also elsewhere on the board
/RelayInputs/RI8A: R312.2; also elsewhere on the board
/RelayInputs/RI8K: D312.2 (A), U308.2; also elsewhere on the board
GND: U301.3, U302.3, U303.3, U304.3, U305.3, U306.3, U307.3, U308.3; also elsewhere on the board
unnamed: D301.1 (K), R301.1, U301.1
unnamed: D302.1 (K), R302.1, U302.1
unnamed: D303.1 (K), R303.1, U303.1
unnamed: D304.1 (K), R304.1, U304.1
unnamed: D305.2 (A), R305.2
unnamed: D306.2 (A), R306.2
unnamed: D307.2 (A), R307.2
unnamed: D308.2 (A), R308.2
unnamed: D309.1 (K), R309.1, U305.1
unnamed: D310.1 (K), R310.1, U306.1
unnamed: D311.1 (K), R311.1, U307.1
unnamed: D312.1 (K), R312.1, U308.1
unnamed: D313.2 (A), R313.2
unnamed: D314.2 (A), R314.2
unnamed: D315.2 (A), R315.2
unnamed: D316.2 (A), R316.2

Notes on the sheet:
Relay Inputs

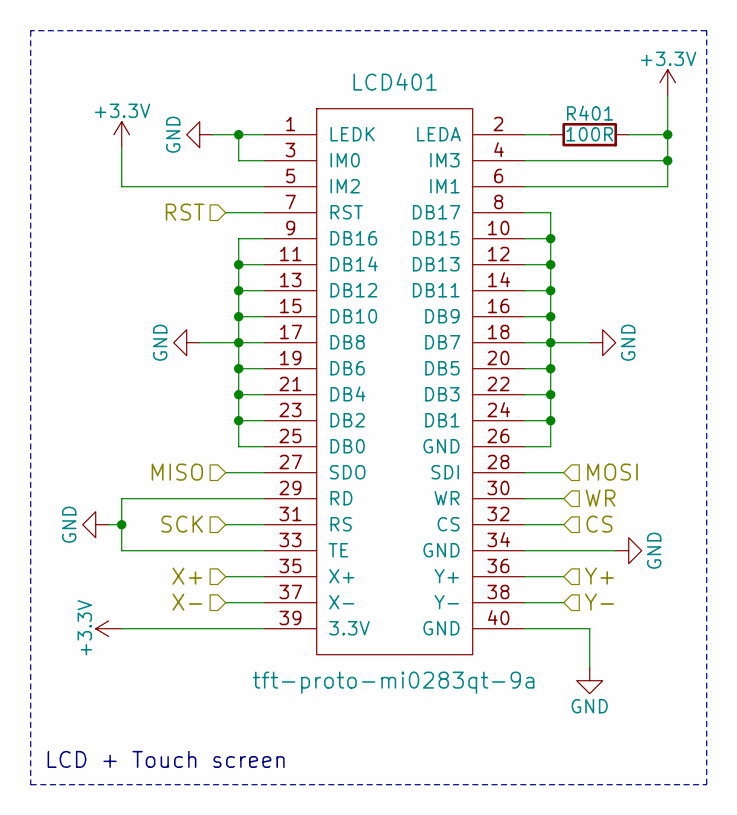
[picture p50: schematic LCDTouchScreen.sch]

Parts:
LCD401: tft-proto-mi0283qt-9a; Pin_Header_Straight_2x20_Pitch2.54mm
R401: 100R; R_0805

Connections:
+3V3: LCD401.4 (IM3), LCD401.5 (IM2), LCD401.6 (IM1), LCD401.39 (3.3V), R401.2; also elsewhere on the board
/LCDTouchScreen/CS: LCD401.32 (CS); also elsewhere on the board
/LCDTouchScreen/MISO: LCD401.27 (SDO); also elsewhere on the board
/LCDTouchScreen/MOSI: LCD401.28 (SDI); also elsewhere on the board
/LCDTouchScreen/RST: LCD401.7 (RST); also elsewhere on the board
/LCDTouchScreen/SCK: LCD401.31 (RS); also elsewhere on the board
/LCDTouchScreen/WR: LCD401.30 (WR); also elsewhere on the board
/Microcontroller/ADC0: LCD401.35 (X+); also elsewhere on the board
/Microcontroller/ADC1: LCD401.36 (Y+); also elsewhere on the board
/Microcontroller/ADC2: LCD401.37 (X-); also elsewhere on the board
/Microcontroller/ADC3: LCD401.38 (Y-); also elsewhere on the board
GND: LCD401.1 (LEDK), LCD401.3 (IM0), LCD401.8 (DB17), LCD401.9 (DB16), LCD401.10 (DB15), LCD401.11 (DB14), LCD401.12 (DB13), LCD401.13 (DB12), LCD401.14 (DB11), LCD401.15 (DB10), LCD401.16 (DB9), LCD401.17 (DB8), LCD401.18 (DB7), LCD401.19 (DB6), LCD401.20 (DB5), LCD401.21 (DB4), LCD401.22 (DB3), LCD401.23 (DB2), LCD401.24 (DB1), LCD401.25 (DB0), LCD401.26 (GND), LCD401.29 (RD), LCD401.33 (TE), LCD401.34 (GND), LCD401.40 (GND); also elsewhere on the board
unnamed: LCD401.2 (LEDA), R401.1

Notes on the sheet:
LCD + Touch screen

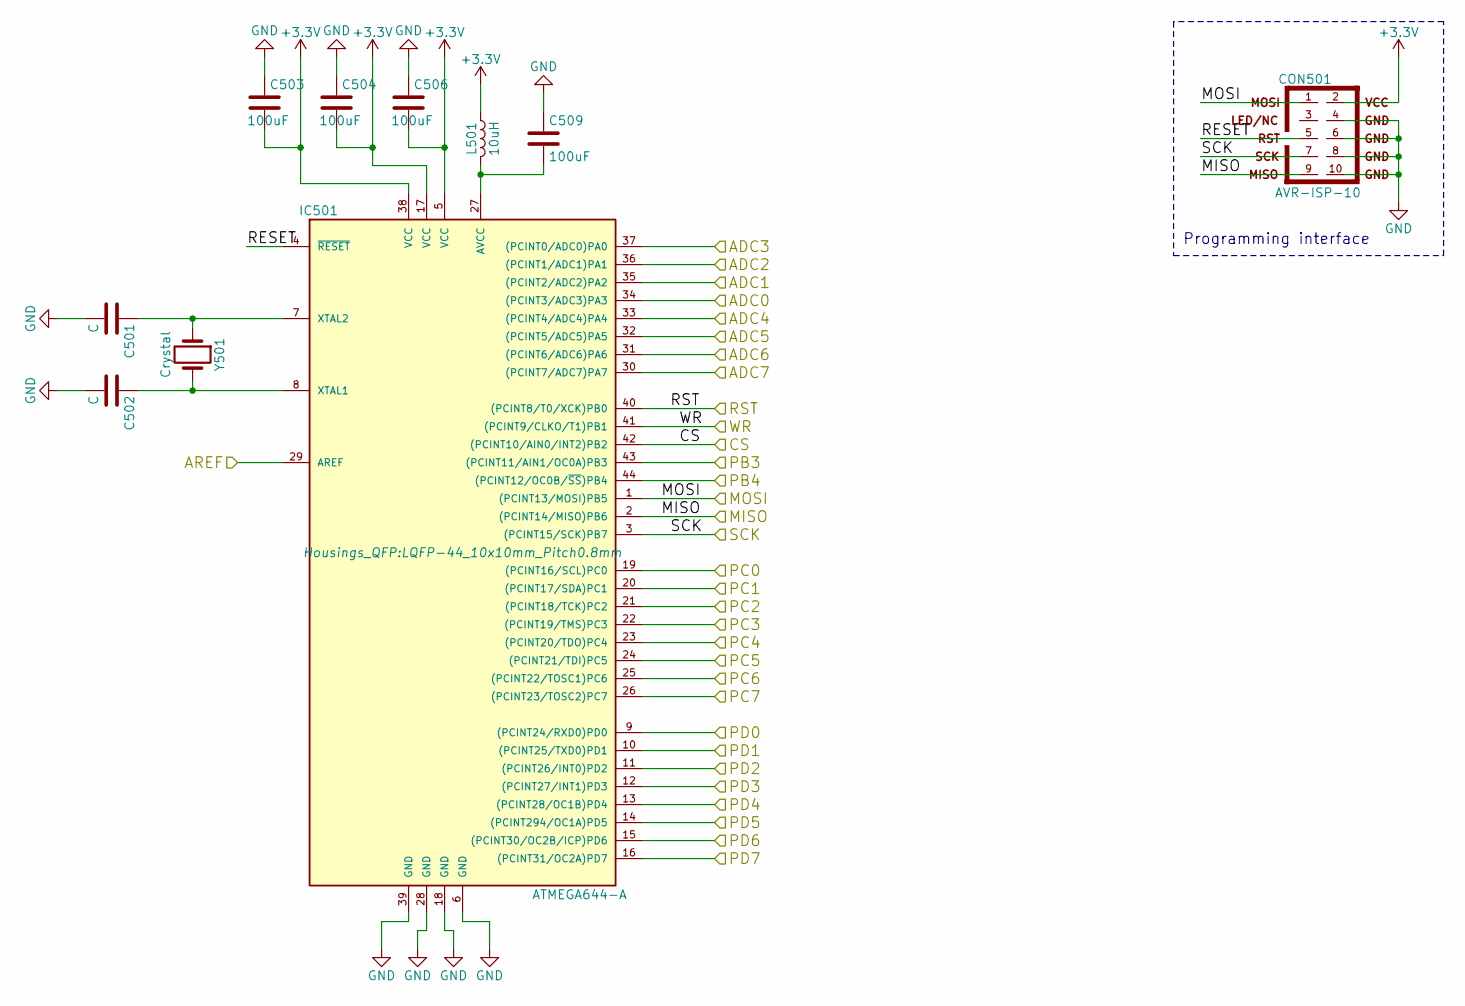
[picture p51: schematic Microcontroller.sch]

Parts:
C501, C502: C; C_0805
C503, C504, C506, C509: 100uF; C_0805
CON501: AVR-ISP-10; IDC_Header_Straight_10pins
IC501: ATMEGA644-A; LQFP-44_10x10mm_Pitch0.8mm
L501: 10uH; C_1206
Y501: Crystal; Crystal_HC49-U_Vertical

Connections:
+3V3: C503.2, C504.2, C506.2, CON501.2, IC501.5 (VCC), IC501.17 (VCC), IC501.38 (VCC), L501.1; also elsewhere on the board
/LCDTouchScreen/CS: IC501.42 ((PCINT10/AIN0/INT2)PB2); also elsewhere on the board
/LCDTouchScreen/MISO: CON501.9, IC501.2 ((PCINT14/MISO)PB6); also elsewhere on the board
/LCDTouchScreen/MOSI: CON501.1, IC501.1 ((PCINT13/MOSI)PB5); also elsewhere on the board
/LCDTouchScreen/RST: IC501.40 ((PCINT8/T0/XCK)PB0); also elsewhere on the board
/LCDTouchScreen/SCK: CON501.7, IC501.3 ((PCINT15/SCK)PB7); also elsewhere on the board
/LCDTouchScreen/WR: IC501.41 ((PCINT9/CLKO/T1)PB1); also elsewhere on the board
/Microcontroller/ADC0: IC501.34 ((PCINT3/ADC3)PA3); also elsewhere on the board
/Microcontroller/ADC1: IC501.35 ((PCINT2/ADC2)PA2); also elsewhere on the board
/Microcontroller/ADC2: IC501.36 ((PCINT1/ADC1)PA1); also elsewhere on the board
/Microcontroller/ADC3: IC501.37 ((PCINT0/ADC0)PA0); also elsewhere on the board
/Microcontroller/ADC4: IC501.33 ((PCINT4/ADC4)PA4); also elsewhere on the board
/Microcontroller/ADC5: IC501.32 ((PCINT5/ADC5)PA5); also elsewhere on the board
/Microcontroller/ADC6: IC501.31 ((PCINT6/ADC6)PA6); also elsewhere on the board
/Microcontroller/ADC7: IC501.30 ((PCINT7/ADC7)PA7); also elsewhere on the board
/Microcontroller/AREF: IC501.29 (AREF); also elsewhere on the board
/Microcontroller/RESET: CON501.5, IC501.4 (~RESET)
/PB3: IC501.43 ((PCINT11/AIN1/OC0A)PB3); also elsewhere on the board
/PB4: IC501.44 ((PCINT12/OC0B/~SS~)PB4); also elsewhere on the board
/RelayInputs/I1: IC501.9 ((PCINT24/RXD0)PD0); also elsewhere on the board
/RelayInputs/I2: IC501.10 ((PCINT25/TXD0)PD1); also elsewhere on the board
/RelayInputs/I3: IC501.11 ((PCINT26/INT0)PD2); also elsewhere on the board
/RelayInputs/I4: IC501.12 ((PCINT27/INT1)PD3); also elsewhere on the board
/RelayInputs/I5: IC501.13 ((PCINT28/OC1B)PD4); also elsewhere on the board
/RelayInputs/I6: IC501.14 ((PCINT294/OC1A)PD5); also elsewhere on the board
/RelayInputs/I7: IC501.15 ((PCINT30/OC2B/ICP)PD6); also elsewhere on the board
/RelayInputs/I8: IC501.16 ((PCINT31/OC2A)PD7); also elsewhere on the board
/RelayOutputs/O1: IC501.26 ((PCINT23/TOSC2)PC7); also elsewhere on the board
/RelayOutputs/O2: IC501.25 ((PCINT22/TOSC1)PC6); also elsewhere on the board
/RelayOutputs/O3: IC501.24 ((PCINT21/TDI)PC5); also elsewhere on the board
/RelayOutputs/O4: IC501.23 ((PCINT20/TDO)PC4); also elsewhere on the board
/RelayOutputs/O5: IC501.22 ((PCINT19/TMS)PC3); also elsewhere on the board
/RelayOutputs/O6: IC501.21 ((PCINT18/TCK)PC2); also elsewhere on the board
/RelayOutputs/O7: IC501.20 ((PCINT17/SDA)PC1); also elsewhere on the board
/RelayOutputs/O8: IC501.19 ((PCINT16/SCL)PC0); also elsewhere on the board
GND: C501.2, C502.2, C503.1, C504.1, C506.1, C509.1, CON501.4, CON501.6, CON501.8, CON501.10, IC501.6 (GND), IC501.18 (GND), IC501.28 (GND), IC501.39 (GND); also elsewhere on the board
unnamed: C501.1, IC501.7 (XTAL2), Y501.1
unnamed: C502.1, IC501.8 (XTAL1), Y501.2
unnamed: C509.2, IC501.27 (AVCC), L501.2

Notes on the sheet:
Programming interface

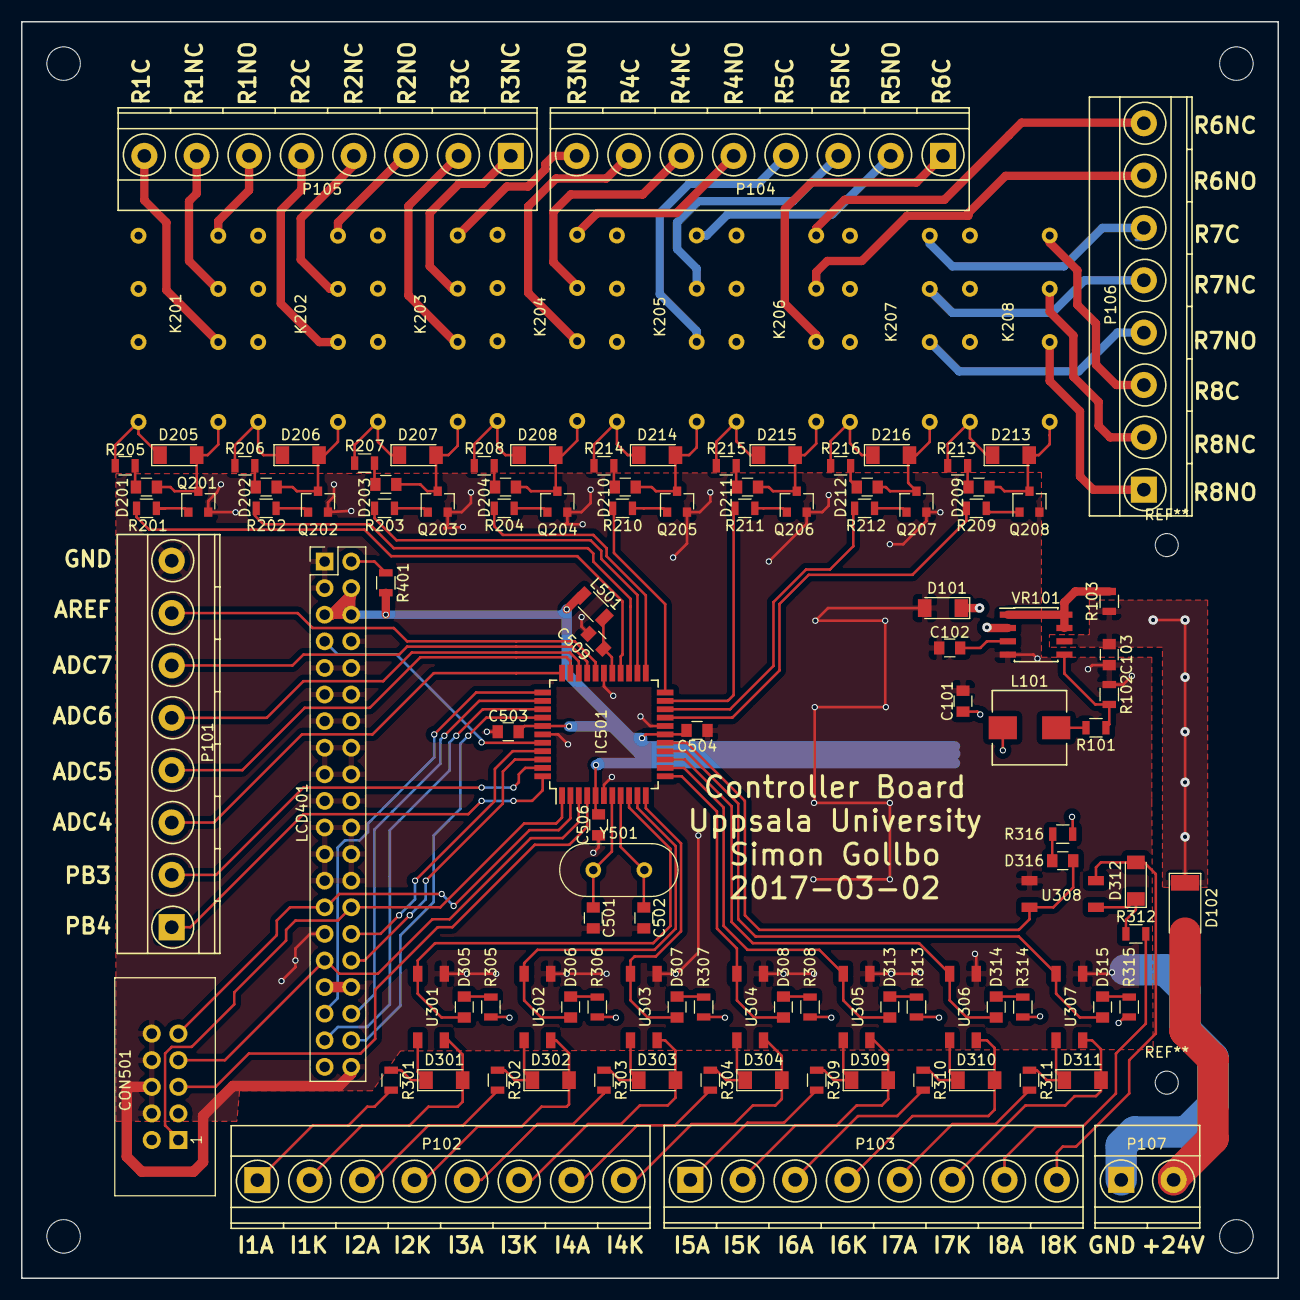
[picture p52: board ControlCircuit.kicad_pcb from above]

Board: 2 copper layers, 120.0 x 120.0 mm, 117 parts (0 on the bottom side), 126 nets.
