Simmz64/EmbeddedProject/(commit log)

2017-02-06 Alterations to testfile. Added Touchscreen firmware for arduino
2017-02-21 Started circuit, first commit
    [ControlCircuit.kicad_pcb, ControlCircuit.sch]
2017-02-22 Schematics and PCB work
    [ControlCircuit.kicad_pcb, ControlCircuit.sch, RelayInputs.sch, RelayOutputs.sch, Relays.sch]
2017-02-23 Continued PCB work, placement started. Report and presentation also started
    [ControlCircuit.kicad_pcb, ControlCircuit.sch, RelayInputs.sch, RelayOutputs.sch]
2017-02-23 Continued PCB work, additional footprints added
    [ControlCircuit.kicad_pcb, ControlCircuit.sch, LCDTouchScreen.sch, Microcontroller.sch, RelayInputs.sch, RelayOutputs.sch]
2017-02-24 Additional PCB work
    [ControlCircuit.kicad_pcb, ControlCircuit.sch, LCDTouchScreen.sch, Microcontroller.sch, RelayInputs.sch, RelayOutputs.sch]
2017-02-27 Routed PCB and made backup. Footprint for Optocouplers
    [ControlCircuit.dsn, ControlCircuit.sch, ControlCircuitBackup.kicad_pcb, LCDTouchScreen.sch, Microcontroller.sch, RelayInputs.sch, RelayOutputs.sch]
2017-02-28 PCB. Pours mostly complete. Almost done?
    [ControlCircuit.kicad_pcb, ControlCircuit.sch, ControlCircuitBackup2.kicad_pcb, LCDTouchScreen.sch, Microcontroller.sch, RelayInputs.sch, RelayOutputs.sch]
2017-02-28 Minor tweak
    [ControlCircuit.kicad_pcb]
2017-03-01 Cleaned up silkscreen. Everything connected.
    [ControlCircuit.sch, ControlCircuitBackup3.kicad_pcb]
2017-03-01 PCB Revision 1
    [ControlCircuit-B.Cu.gbr, ControlCircuit-B.Mask.gbr, ControlCircuit-Edge.Cuts.gbr, ControlCircuit-F.Cu.gbr, ControlCircuit-F.Mask.gbr, ControlCircuit-F.SilkS.gbr, ControlCircuit-drl_map.gbr, ControlCircuit.drl]
2017-03-02 PCB rev 1 ordered. Components counted
    [BillOfMaterials_ControlCircuit.xlsx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]
2017-03-08 Bill of materials updated
    [BillOfMaterials_ControlCircuit.xlsx]
2017-03-16 Modified the Vacuum chamber drawing
2017-03-16 Report writing
    [BillOfMaterials_ControlCircuit.xlsx, ControlCircuit.kicad_pcb, ControlCircuit.sch]
